ArudhranPK/VECTRON_V1/Hardware/Drawings/IMG_3359.JPG

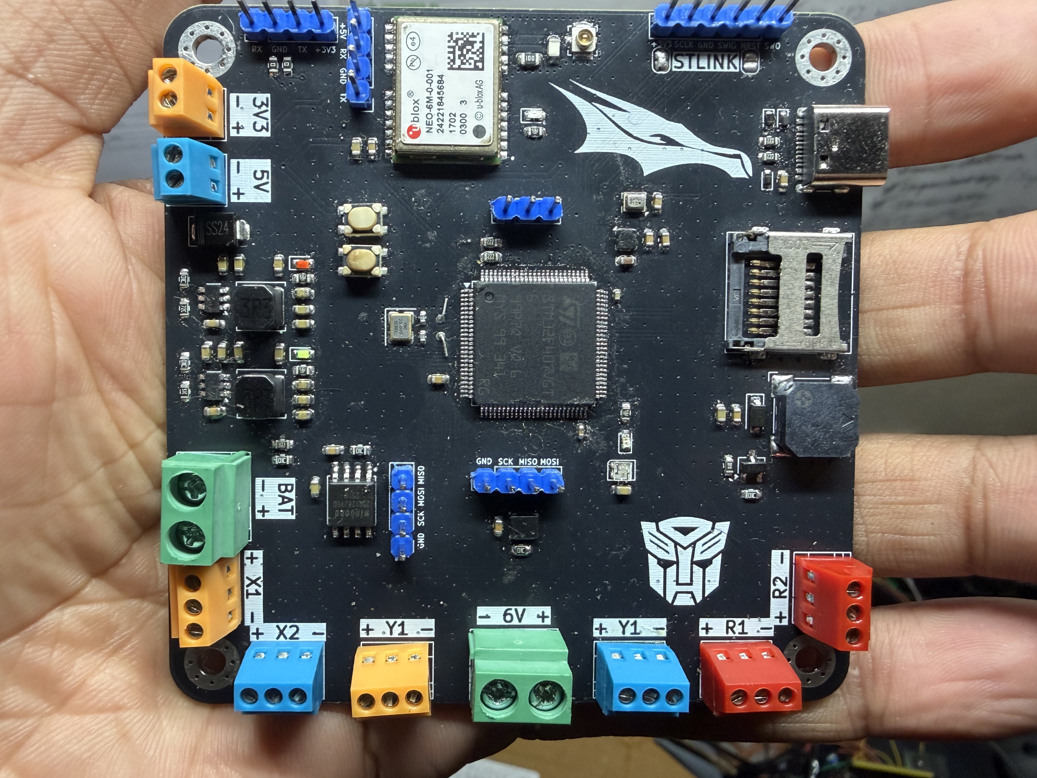
Hardware/Drawings/IMG_3359.JPG
