ArudhranPK/VECTRON_V1/Hardware/Drawings/IMG_3377.PNG

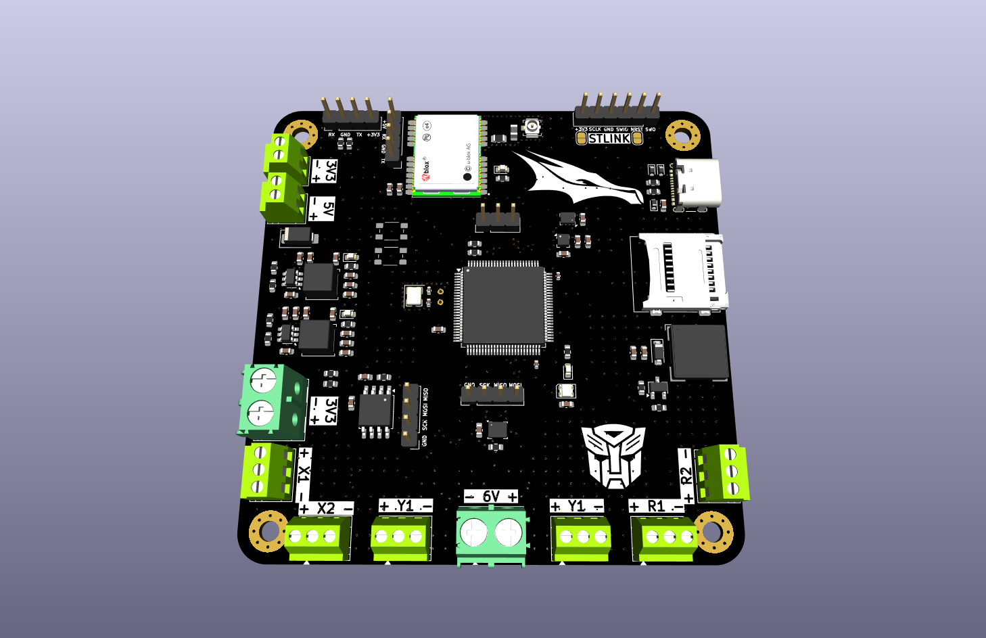
Hardware/Drawings/IMG_3377.PNG
