ArudhranPK/VECTRON_V1/Planning.md

# **Planning**

## **First thing to do**

Remember to make custom symbols
- [ ] Proper schematics with datasheet references (footprint later on)

## **Software**

### Micro SD card (SDIO)
- [x] integration testing
- [ ] Driver code

### SPI Flash (SPI)
- [x] integration testing
- [ ] Driver code

### ISM330DHCX IMU (SPI)(DMA)
- [x] Integration testing
- [x] Driver code

### LIS2MDL magnetometer (I2C)
- [x] integration testing
- [x] Driver code

### NEO-6M GPS (UART)
- [x] integration testing
- [x] Driver code

### BMP280 barometer (I2C)
- [x] integration testing
- [x] Driver code

## **Hardware**

Remeber to make custom footprints

- [x] Complete schematic fully
- [x] Check schematics (Find errors)
- [x] Check if Micro SD can be run by only 1 bit bus
- [ ] Check for simulations
- [ ] Learn about Control Systems
- [ ] Learn about Control Systems for rockets
- [ ] Check for the Op-Amp and mosfet trigger and continuity
- [ ] Check for the automatic switch from battery to usb
- [ ] Check for the reverse polarity circuit is working or not
