ArudhranPK/VECTRON_V1/Hardware/BOM.xlsx

Value | Qty |  | Exclude from BOM | Exclude from Board | Footprint
Battery_Cell | 1 | https://robu.in/product/panasonic-cr2032-3v-lithium-coin-battery-2pcs/ |  |  | Battery:BatteryHolder_Multicomp_BC-2001_1x2032_1
CL8530A-CLDZ | 1 |  |  |  | Buzzer_Beeper:MagneticBuzzer_CUI_CMT-8504-100-SMT
10uf | 29 | https://robu.in/product/0603x106m250nt-fh-25v-10uf-x5r%c2%b120-0603-multilayer-ceramic-capacitors-mlcc-smd-smt-rohs/ |  |  | Capacitor_SMD:C_0603_1608Metric
100nf | 21 | https://robu.in/product/cl10b104kb8nfnc-samsang-50v-100nf-x7r-%c2%b110-0603-multilayer-ceramic-capacitors-mlcc-smd-smt-rohs/ |  |  | Capacitor_SMD:C_0603_1608Metric
220nf | 1 | https://robu.in/product/cl10b224kb8nnnc-samsang-50v-220nf-x7r-%c2%b110-0603-multilayer-ceramic-capacitors-mlcc-smd-smt-rohs/ |  |  | Capacitor_SMD:C_0603_1608Metric
27pf | 1 | https://robu.in/product/grm1555c1h270ga01d-murata-cap-ceramic-27pf-50v-c0g-2-pad-smd-0402-125c-t-r/ |  |  | Capacitor_SMD:C_0402_1005Metric
15pf | 1 | https://robu.in/product/grm1555c1h150ga01d-murata-cap-ceramic-15pf-50v-c0g-2-pad-smd-0402-125c-t-r/ |  |  | Capacitor_SMD:C_0402_1005Metric
33pf | 1 | https://robu.in/product/grm1555c1h330ga01d-murata-cap-ceramic-33pf-50v-c0g-2-pad-smd-0402-125c-t-r/ |  |  | Capacitor_SMD:C_0402_1005Metric
22pf | 1 | https://robu.in/product/grm1555c1h220ga01d-murata-cap-ceramic-22pf-50v-c0g-2-pad-smd-0402-125c-t-r/ |  |  | Capacitor_SMD:C_0402_1005Metric
18pf | 1 | https://robu.in/product/grm1555c1h180fa01d-murata-cap-ceramic-18pf-50v-c0g-1-pad-smd-0402-125c-t-r/ |  |  | Capacitor_SMD:C_0402_1005Metric
11pf | 1 | https://robu.in/product/grm1555c1h110ga01d-murata-cap-ceramic-11pf-50v-c0g-2-pad-smd-0402-125c-t-r/ |  |  | Capacitor_SMD:C_0402_1005Metric
2u2f | 2 | https://robu.in/product/0402x225k160nt-fh-16v-2-2uf-x5r%c2%b110-0402-multilayer-ceramic-capacitors-mlcc-smd-smt-rohs/ |  |  | Capacitor_SMD:C_0402_1005Metric
SS24B-Slkor | 1 | https://robu.in/product/ss24b-slkor-40v-500mv2a-2a-smbdo-214aa-schottky-diodes-rohs/ |  |  | Diode_SMD:D_SMA
MM5Z10B | 1 | https://robu.in/product/mm5z10b-semtech-200mw-10v-sod-523-zener-diodes-rohs/ |  |  | Diode_SMD:D_SOD-523
white | 4 | https://robu.in/product/xl-1608wwc-06-xinglight-20ma-780mcd-yellow-lens-20%e2%84%8385%e2%84%83-positive-stick-white-130-70mw-3-3v-0603-led-indication-discrete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 |  |  | LED_SMD:LED_0603_1608Metric
red | 4 | https://robu.in/product/xl-1608surc-04-xinglight-20ma-360mcd-colorless-transparent-lens-615nm625nm-20%e2%84%8385%e2%84%83-positive-stick-red-120-50mw-2-4v-060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
blue | 4 | https://robu.in/product/xl-1608bgwc-06-xinglight-20ma-960mcd-green-lens-20%e2%84%8385%e2%84%83-positive-stick-blue-120-70mw-3-3v-0603-led-indication-discrete-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
green | 4 | https://robu.in/product/xl-1608sygc-06-xinglight-25ma-2800k3160k-60mcd-colorless-transparent-lens-30%e2%84%8385%e2%84%83-positive-stick-570nm575nm-yellow-gree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
1N4148W | 1 | https://robu.in/product/1n4148w-7-f-diodes-incorporated-100v-independent-type-1-25v150ma-4ns-300ma-sod-123-switching-diodes-rohs/ |  |  | Diode_SMD:D_SOD-123
WS2812B-2020 | 1 | https://robu.in/product/1-month-warranty-953/ |  |  | LED_SMD:LED_WS2812B-2020_PLCC4_2.0x2.0mm
PESD5V0U1BB | 2 | https://robu.in/product/pesd5v0u1bb115-nexperia-5-5v-bidirectional-5v-sod-523-esd-and-surge-protection-tvs-esd-rohs/ |  |  | Diode_SMD:D_SOD-523
SLESD5Z5C | 2 | https://robu.in/product/slesd5z5c-slkor-5-6v-bidirectional-5v-sod-523-esd-and-surge-protection-tvs-esd-rohs/ |  |  | Diode_SMD:D_SOD-523
BLM18AG121SN1D | 1 | https://robu.in/product/blm18ag121sn1d-murata-ferrite-beads-multi-layer-120ohm-25-100mhz-0-8a-0-18ohm-dcr-0603-t-r/ |  |  | Inductor_SMD:L_0603_1608Metric
Screw_01x02 | 1 | https://robu.in/product/xy308-2-54-xinya-2-pin-screw-terminal-blockorange/ |  |  | TerminalBlock:TerminalBlock_Xinya_XY308-2.54-2P_1x02_P2.54mm_Horizontal
Screw_01x02 | 1 | https://robu.in/product/xy308-2-54-xinya-2-pin-screw-terminal-blockblue/
Screw_01x02 | 2 |  |  |  | TerminalBlock_RND:TerminalBlock_RND_205-00045_1x02_P5.00mm_Horizontal
01x06_Pin | 1 |  |  |  | Connector_PinHeader_2.54mm:PinHeader_1x06_P2.54mm_Vertical
01x04_Pin | 4 |  |  |  | Connector_PinHeader_2.54mm:PinHeader_1x04_P2.54mm_Vertical
Micro_SD_Card | 1 |  |  |  | Connector_Card:microSD_HC_Molex_47219-2001
Screw_01x03 | 2 | https://robu.in/product/xy308-2-54-xinya-3-pin-screw-terminal-blockorange/ |  |  | TerminalBlock:TerminalBlock_Xinya_XY308-2.54-3P_1x03_P2.54mm_Horizontal
Screw_01x03 | 2 | https://robu.in/product/xy308-2-54-xinya-3-pin-screw-terminal-blockred/
Screw_01x03 | 2 | https://robu.in/product/xy308-2-54-xinya-3-pin-screw-terminal-blockblue/
01x03_Pin | 1 |  |  |  | Connector_PinHeader_2.54mm:PinHeader_1x03_P2.54mm_Vertical
USB_C_Receptacle_USB2.0_16P | 1 | https://robu.in/product/type-c-31-m-38-hroparts-5a-1-16p-female-30%e2%84%8380%e2%84%83-type-c-smd-usb-connectors-rohs/ |  |  | Connector_USB:USB_C_Receptacle_GCT_USB4105-xx-A_16P_TopMnt_Horizontal
SWPA5040S3R3NT 3u3h | 2 | https://robu.in/product/swpa5040s3r3nt-sunlord-3-3uh-30-3-4a-24-ohm-smd-5-0x5-0x4-0mm-power-inductord319/ |  |  | Inductor_SMD:L_Sunlord_SWPA5040S
27uh | 1 | https://robu.in/product/mlf2012c220kt000-tdk-5ma-22uh-%c2%b110-450m%cf%89-0805-inductors-smd-rohs/ |  |  | Inductor_SMD:L_0805_2012Metric
SiS447DN | 1 | https://robu.in/product/sis447dn-t1-ge3-vishay-sis447dn-t1-ge3-power-mosfet-p-channel-20-v-18-a-0-0058-ohm-powerpak-1212-surface-mount/ |  |  | Package_SO:Vishay_PowerPAK_1212-8_Single
AC0603FR-0710KL | 1 | https://robu.in/product/irlml2502trpbf-jsmsemi-20v-4-5a-80m%cf%891-8v2a-1-5w-1v-1-n-channel-sot-23-mosfets-rohs/ |  |  | Package_TO_SOT_SMD:TSOT-23
10k | 21 | https://robu.in/product/rc0603fr-0710kl-yageo-res-thick-film-0603-10k-ohm-1-0-1w1-10w-%c2%b1100ppm-c-pad-smd-t-r/ |  |  | Resistor_SMD:R_0603_1608Metric
2k2 | 2 | https://robu.in/product/0603waf2201t5e-uniohm-royal-ohm-100mw-thick-film-resistors-75v-%c2%b1100ppm-%e2%84%83-%c2%b11-2-2k%cf%89-0603-chip-resistor-surface-mo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 |  |  | Resistor_SMD:R_0603_1608Metric
0Î© | 3 | https://robu.in/product/0603waf0000t5e-uniohm-royal-ohm-100mw-thick-film-resistors-75v-%c2%b11-0%cf%89-0603-chip-resistor-surface-mount-rohs/ |  |  | Resistor_SMD:R_0603_1608Metric
1k | 1 | https://robu.in/product/rc0603jr-071kl-yageo-res-thick-film-0603-1k-ohm-5-0-1w1-10w-%c2%b1100ppm-c-pad-smd-t-r/ |  |  | Resistor_SMD:R_0603_1608Metric
5k1 | 4 | https://robu.in/product/0603waj0512t5e-uniohm-royal-ohm-100mw-thick-film-resistors-75v-%c2%b1100ppm-%e2%84%83-%c2%b15-5-1k%cf%89-0603-chip-resistor-surface-mo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 |  |  | Resistor_SMD:R_0603_1608Metric
33K2 | 1 | https://robu.in/product/0603waf3322t5e-uniohm-royal-ohm-100mw-thick-film-resistors-75v%c2%b1100ppm-%e2%84%83-%c2%b11-33-2k%cf%89-0603-chip-resistor-surface-mo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 |  |  | Resistor_SMD:R_0603_1608Metric
10Î© | 1 | https://robu.in/product/0805w8j0100t5e-uniohm-royal-ohm-125mw-thick-film-resistors-150v-%c2%b15-%c2%b1200ppm-%e2%84%83-10%cf%89-0805-chip-resistor-surface-mou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 |  |  | Resistor_SMD:R_0805_2012Metric
54k9 | 1 | https://robu.in/product/0603waf5492t5e-uniohm-royal-ohm-100mw-thick-film-resistors-75v-%c2%b1100ppm-%e2%84%83%c2%b11-54-9k%cf%89-0603-chip-resistor-surface-mo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 |  |  | Resistor_SMD:R_0603_1608Metric
10Î© | 1 | https://robu.in/product/0603waf100jt5e-uniohm-royal-ohm-100mw-thick-film-resistors-75v-%c2%b11-%c2%b1400ppm-%e2%84%8310%cf%89-0603-chip-resistor-surface-mount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 |  |  | Resistor_SMD:R_0603_1608Metric
360 | 1 | https://robu.in/product/0603waf3600t5e-uniohm-royal-ohm-100mw-thick-film-resistors-75v-%c2%b1100ppm-%e2%84%83-%c2%b11-360%cf%89-0603-chip-resistor-surface-mou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 |  |  | Resistor_SMD:R_0603_1608Metric
4k7 | 1 | https://robu.in/product/0603waj0472t5e-uniohm-royal-ohm-100mw-thick-film-resistors-75v-%c2%b1100ppm-%e2%84%83%c2%b15-4-7k%cf%89-0603-chip-resistor-surface-mou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 |  |  | Resistor_SMD:R_0603_1608Metric
30k | 1 | https://robu.in/product/0603waf3002t5e-uniohm-royal-ohm-100mw-thick-film-resistors-75v-%c2%b1100ppm-%e2%84%83%c2%b11-30k%cf%89-0603-chip-resistor-surface-moun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 |  |  | Resistor_SMD:R_0603_1608Metric
750 | 1 | https://robu.in/product/0603waf7500t5e-uniohm-royal-ohm-100mw-thick-film-resistors-75v-%c2%b1100ppm-%e2%84%83-%c2%b11-750%cf%89-0603-chip-resistor-surface-mou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 |  |  | Resistor_SMD:R_0603_1608Metric
27Î© | 1 | https://robu.in/product/0603waf270jt5e-uniohm-royal-ohm-100mw-thick-film-resistors-75v-%c2%b11-%c2%b1200ppm-%e2%84%83-27%cf%89-0603-chip-resistor-surface-moun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 |  |  | Resistor_SMD:R_0603_1608Metric
560 | 1 | https://robu.in/product/0603waf5600t5e-uniohm-royal-ohm-100mw-thick-film-resistors-75v-%c2%b1100ppm-%e2%84%83-%c2%b11-560%cf%89-0603-chip-resistor-surface-mou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 |  |  | Resistor_SMD:R_0603_1608Metric
22Î© | 1 | https://robu.in/product/0603waf220jt5e-uniohm-royal-ohm-100mw-thick-film-resistors-75v-%c2%b1100ppm-%e2%84%83%c2%b11-22%cf%89-0603-chip-resistor-surface-mount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 |  |  | Resistor_SMD:R_0603_1608Metric
TSA017A2518B | 2 | https://robu.in/product/tsa017a2518b-bzcn-3-4mm-2-5mm-50ma-5-2mm-30000-times-180gf-12v-smd-4p5-2x3-3mm-tactile-switches-rohs/ |  |  | TSA017A2518B:TSA017A2518B
BMP280 | 1 |  |  |  | Package_LGA:Bosch_LGA-8_2x2.5mm_P0.65mm_ClockwisePinNumbering
LIS2MDL | 1 |  |  |  | Package_LGA:LGA-12_2x2mm_P0.5mm
ISM330DHCX | 1 |  |  |  | Package_LGA:LGA-14_3x2.5mm_P0.5mm_LayoutBorder3x4y
NEO-6M-GPS | 1 |  |  |  | NEO-6M-GPS:XCVR_NEO-6M-GPS
TPS563201 | 2 | https://robu.in/product/tps563201ddcr-texas-instruments-step-down-type-adjustable-768mv7v-3a-4-5v17v-sot-23-thin-6-dc-dc-converters-rohs/ |  |  | Package_TO_SOT_SMD:SOT-23-6
W25Q128JVS | 1 |  |  |  | Package_SO:SOIC-8_5.3x5.3mm_P1.27mm
STM32F407VGTx | 1 |  |  |  | Package_QFP:LQFP-100_14x14mm_P0.5mm
YSX321SL-25MHz | 1 |  |  |  | Crystal:Crystal_SMD_3225-4Pin_3.2x2.5mm
YXC-Y-26 | 1 |  |  |  | Crystal:Crystal_DS26_D2.0mm_L6.0mm_Horizontal
