ArudhranPK/VECTRON_V1/Hardware/robuBOM.xlsx

MPN | Qty
0603X106M250NT | 87
CL10B104KA8NNWC | 63
CL10B224KB8NNNC | 3
GRM1555C1H270GA01D | 3
GRM1555C1H150GA01D | 3
GRM1555C1H330GA01D | 3
GRM1555C1H220GA01D | 3
GRM1555C1H180FA01D | 3
GRM1555C1H110GA01D | 3
0402X225K160NT | 6
SS24B | 3
MM5Z10B | 3
XL-1608WWC-06 | 12
XL-1608SURC-04 | 12
XL-1608BGWC-06 | 12
XL-1608SYGC-06 | 12
1N4148W-7-F | 3
XL-2020RGBC-WS2812B | 3
SLESD5Z5C | 6
BLM18AG121SN1D | 3
SWPA5040S3R3NT | 6
MLF2012C220KT000 | 3
SIS447DN-T1-GE3 | 3
AO3400A | 3
AC0603FR-0710KL | 63
0603WAF2201T5E | 6
0603WAF0000T5E | 9
RC0603JR-071KL | 3
0603WAJ0512T5E | 12
0603WAF3322T5E | 3
0805W8J0100T5E | 3
0603WAF5492T5E | 3
0603WAF100JT5E | 3
0603WAF3600T5E | 3
0603WAJ0472T5E | 3
0603WAF3002T5E | 3
0603WAF7500T5E | 3
0603WAF270JT5E | 3
0603WAF5600T5E | 3
0603WAF220JT5E | 3
TSA017A2518B | 6
TPS563201DDCR | 6
