ArudhranPK/VECTRON_V1/Hardware/Drawings/PCB.pdf

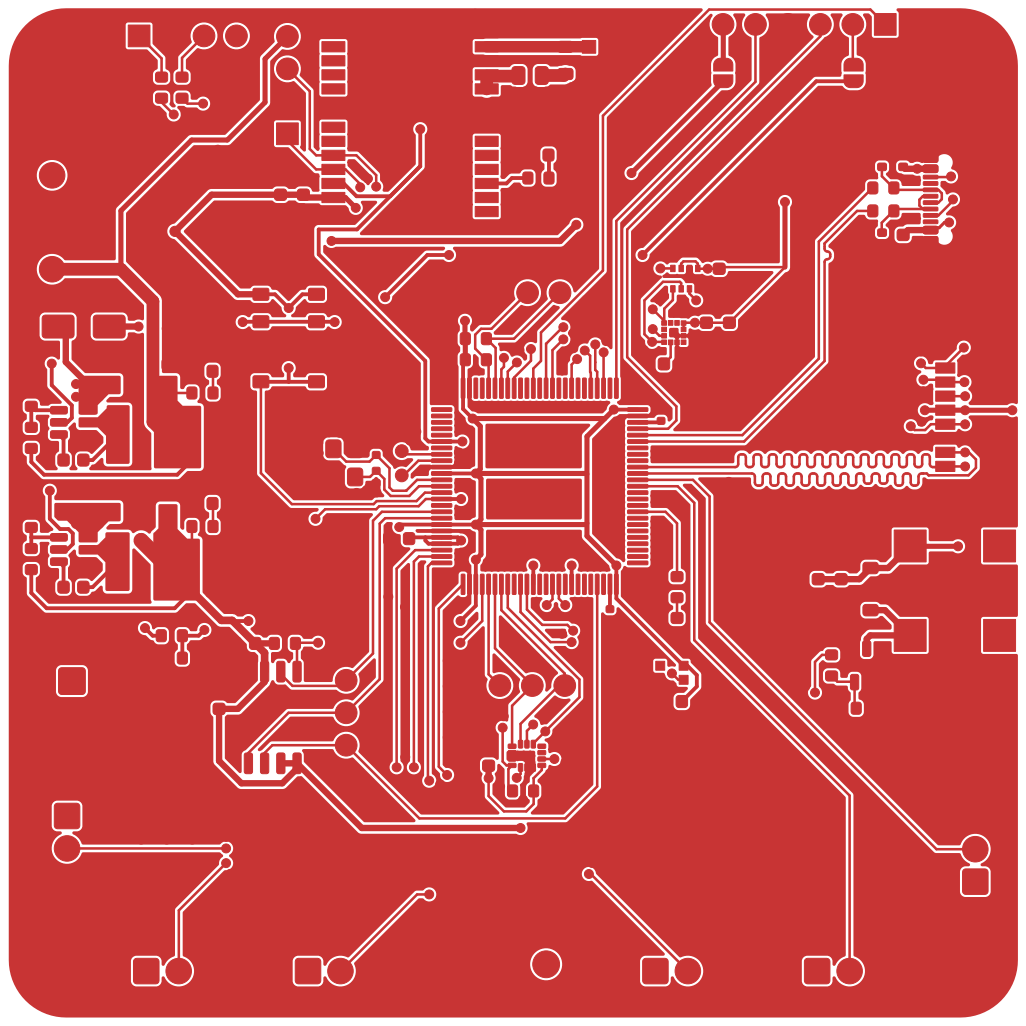
[picture p3: page 1]

Id: 1/2 Title: File: VECTRON_V1.kicad_pcb Sheet:

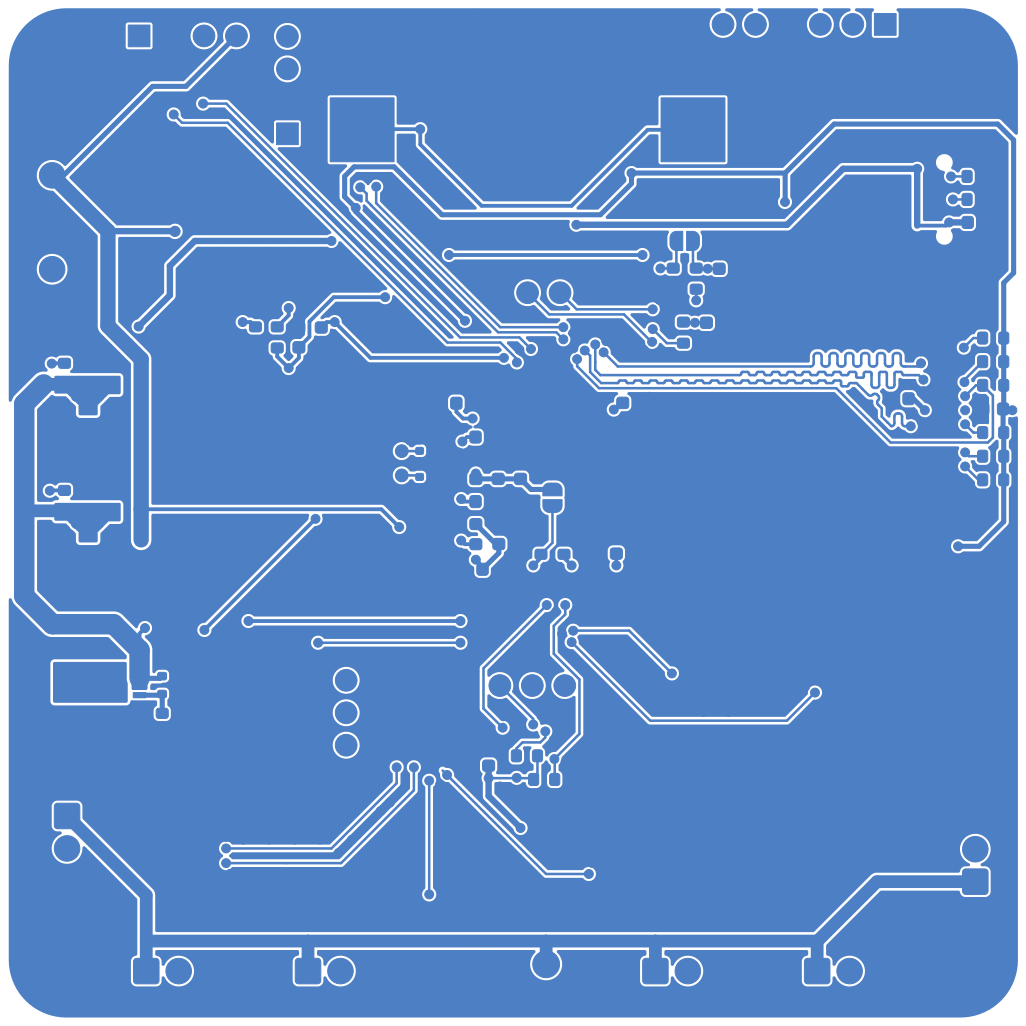
[picture p4: page 2]

Id: 2/2 Title: File: VECTRON_V1.kicad_pcb Sheet:
