ArudhranPK/VECTRON_V1/Hardware/Drawings/Schematics.pdf

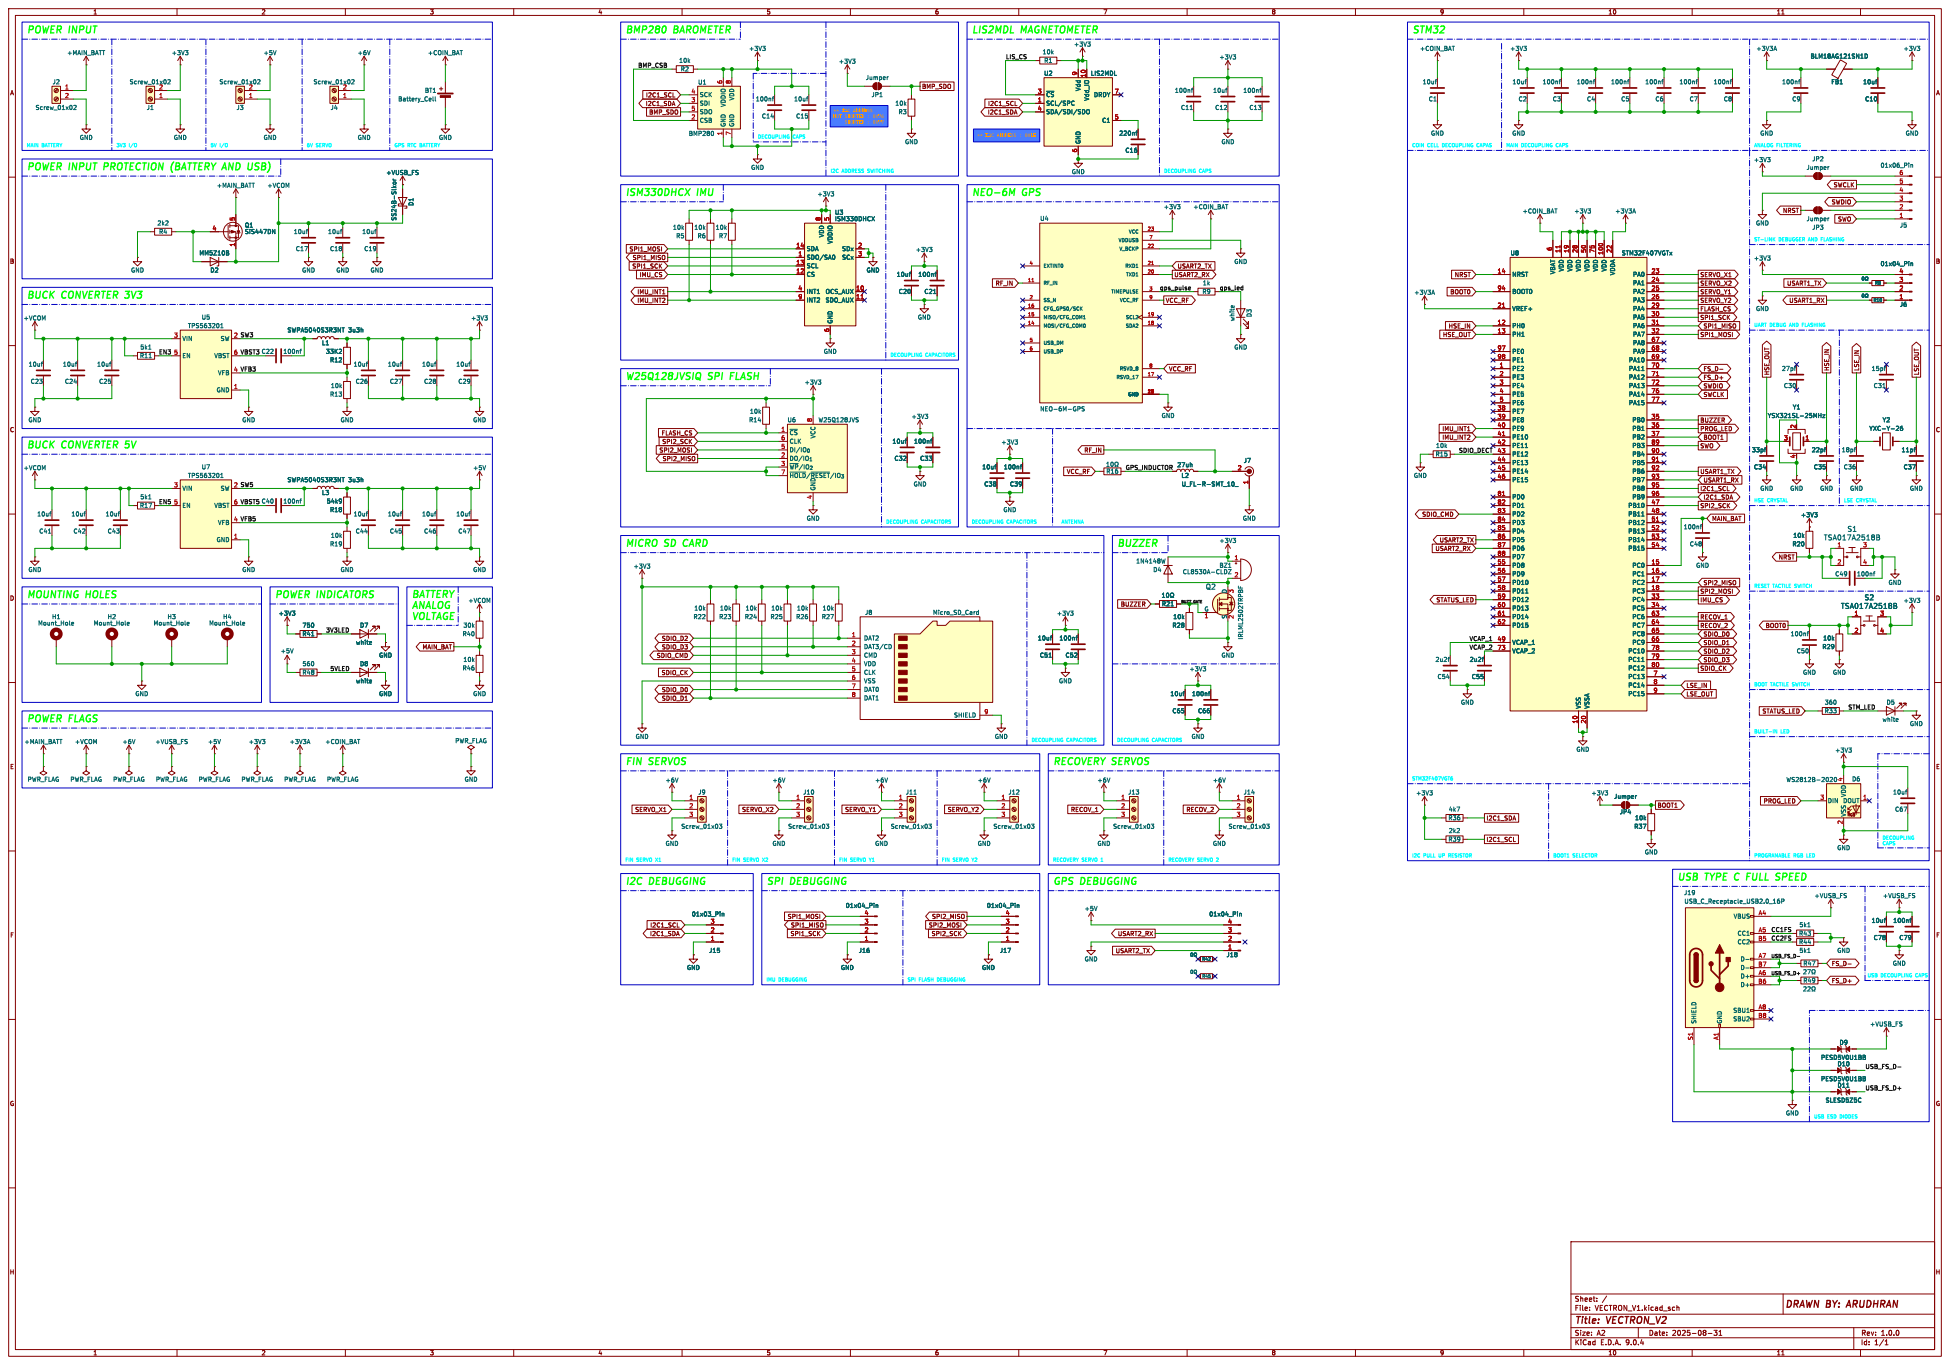
[picture p5: page 1]

MAIN BATTERY POWER INPUT

** I2C ADDRESS NOT SHORTED: 0X76 SHORTED: 0X77

COIN CELL DECOUPLING CAPAS DECOUPLING CAPS
ISM330DHCX GND

MAIN DECOUPLING CAPS POWER FLAGS
POWER INPUT PROTECTION (BATTERY AND USB)
DECOUPLING CAPS MOUNTING HOLES

SDA 14 SDO/SA0 1 SCL 13 CS 12

6 VDD 11 VDD 19 VDD 28 VSS 10 VDD 50 VSSA 20 VDD 75 VDD 100 VDDA 22 PA0
14 BOOT0

INT1 4
DECOUPLING CAPACITORS

RECOVERY SERVO 2 GPS DEBUGGING

USB TYPE C FULL SPEED
