ArudhranPK/VECTRON_V1/Hardware/KiCAD files/VECTRON_V1.kicad_pcb

## KiCad design Hardware/KiCAD files/VECTRON_V1.kicad_pcb (2025-11-18)

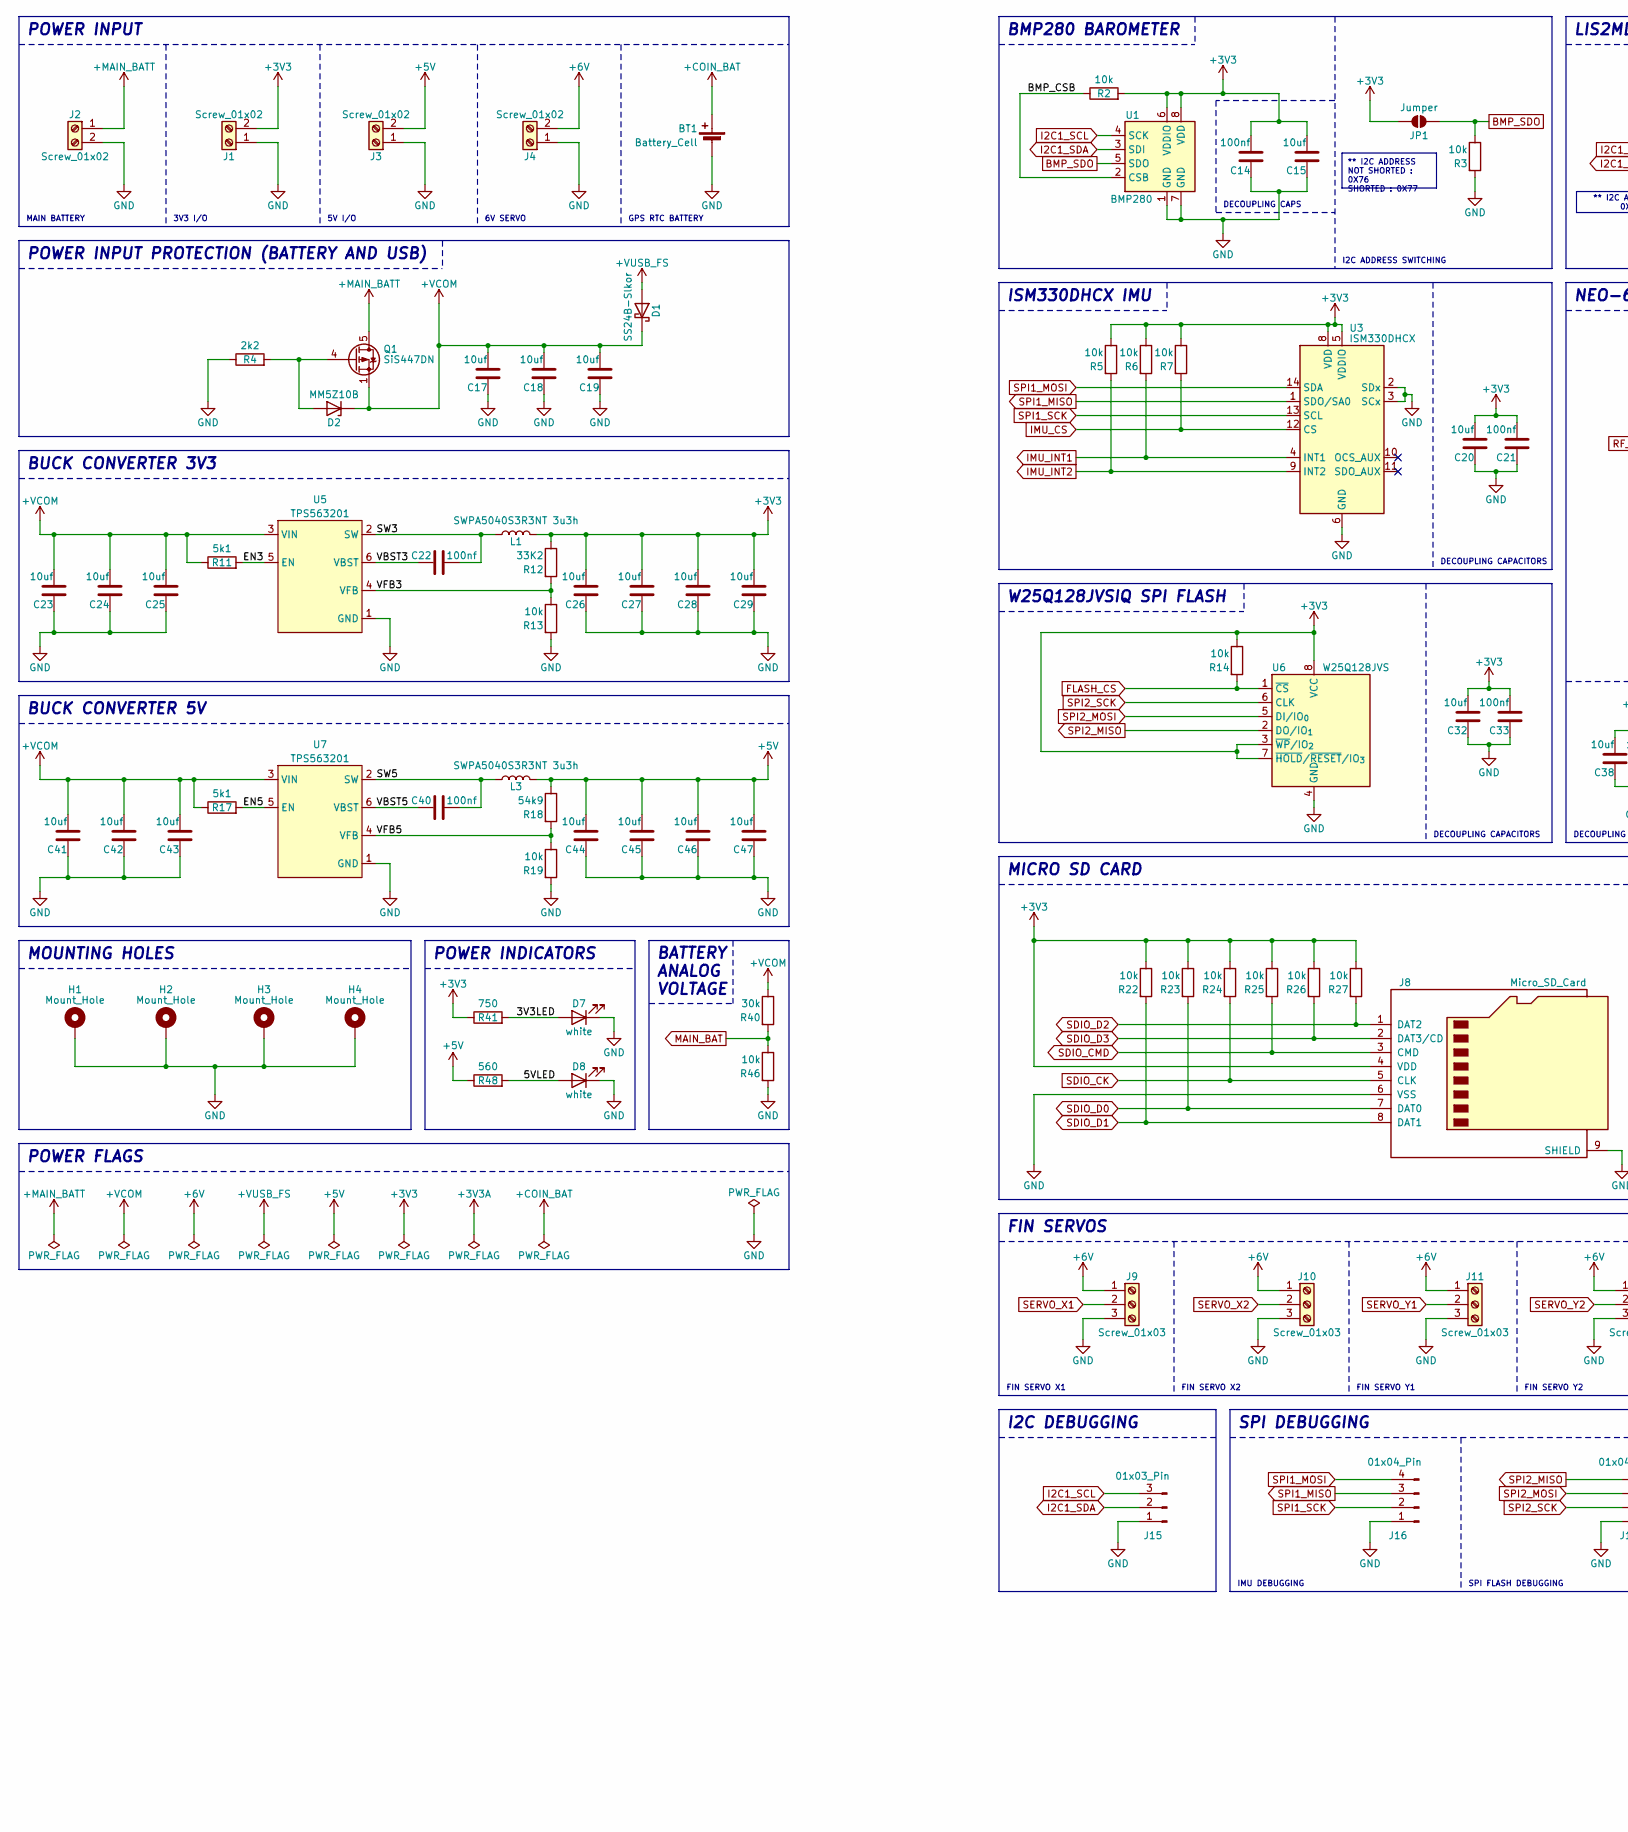
[picture p6: schematic VECTRON_V1.kicad_sch, VECTRON_V2, part in row 1, column 1]

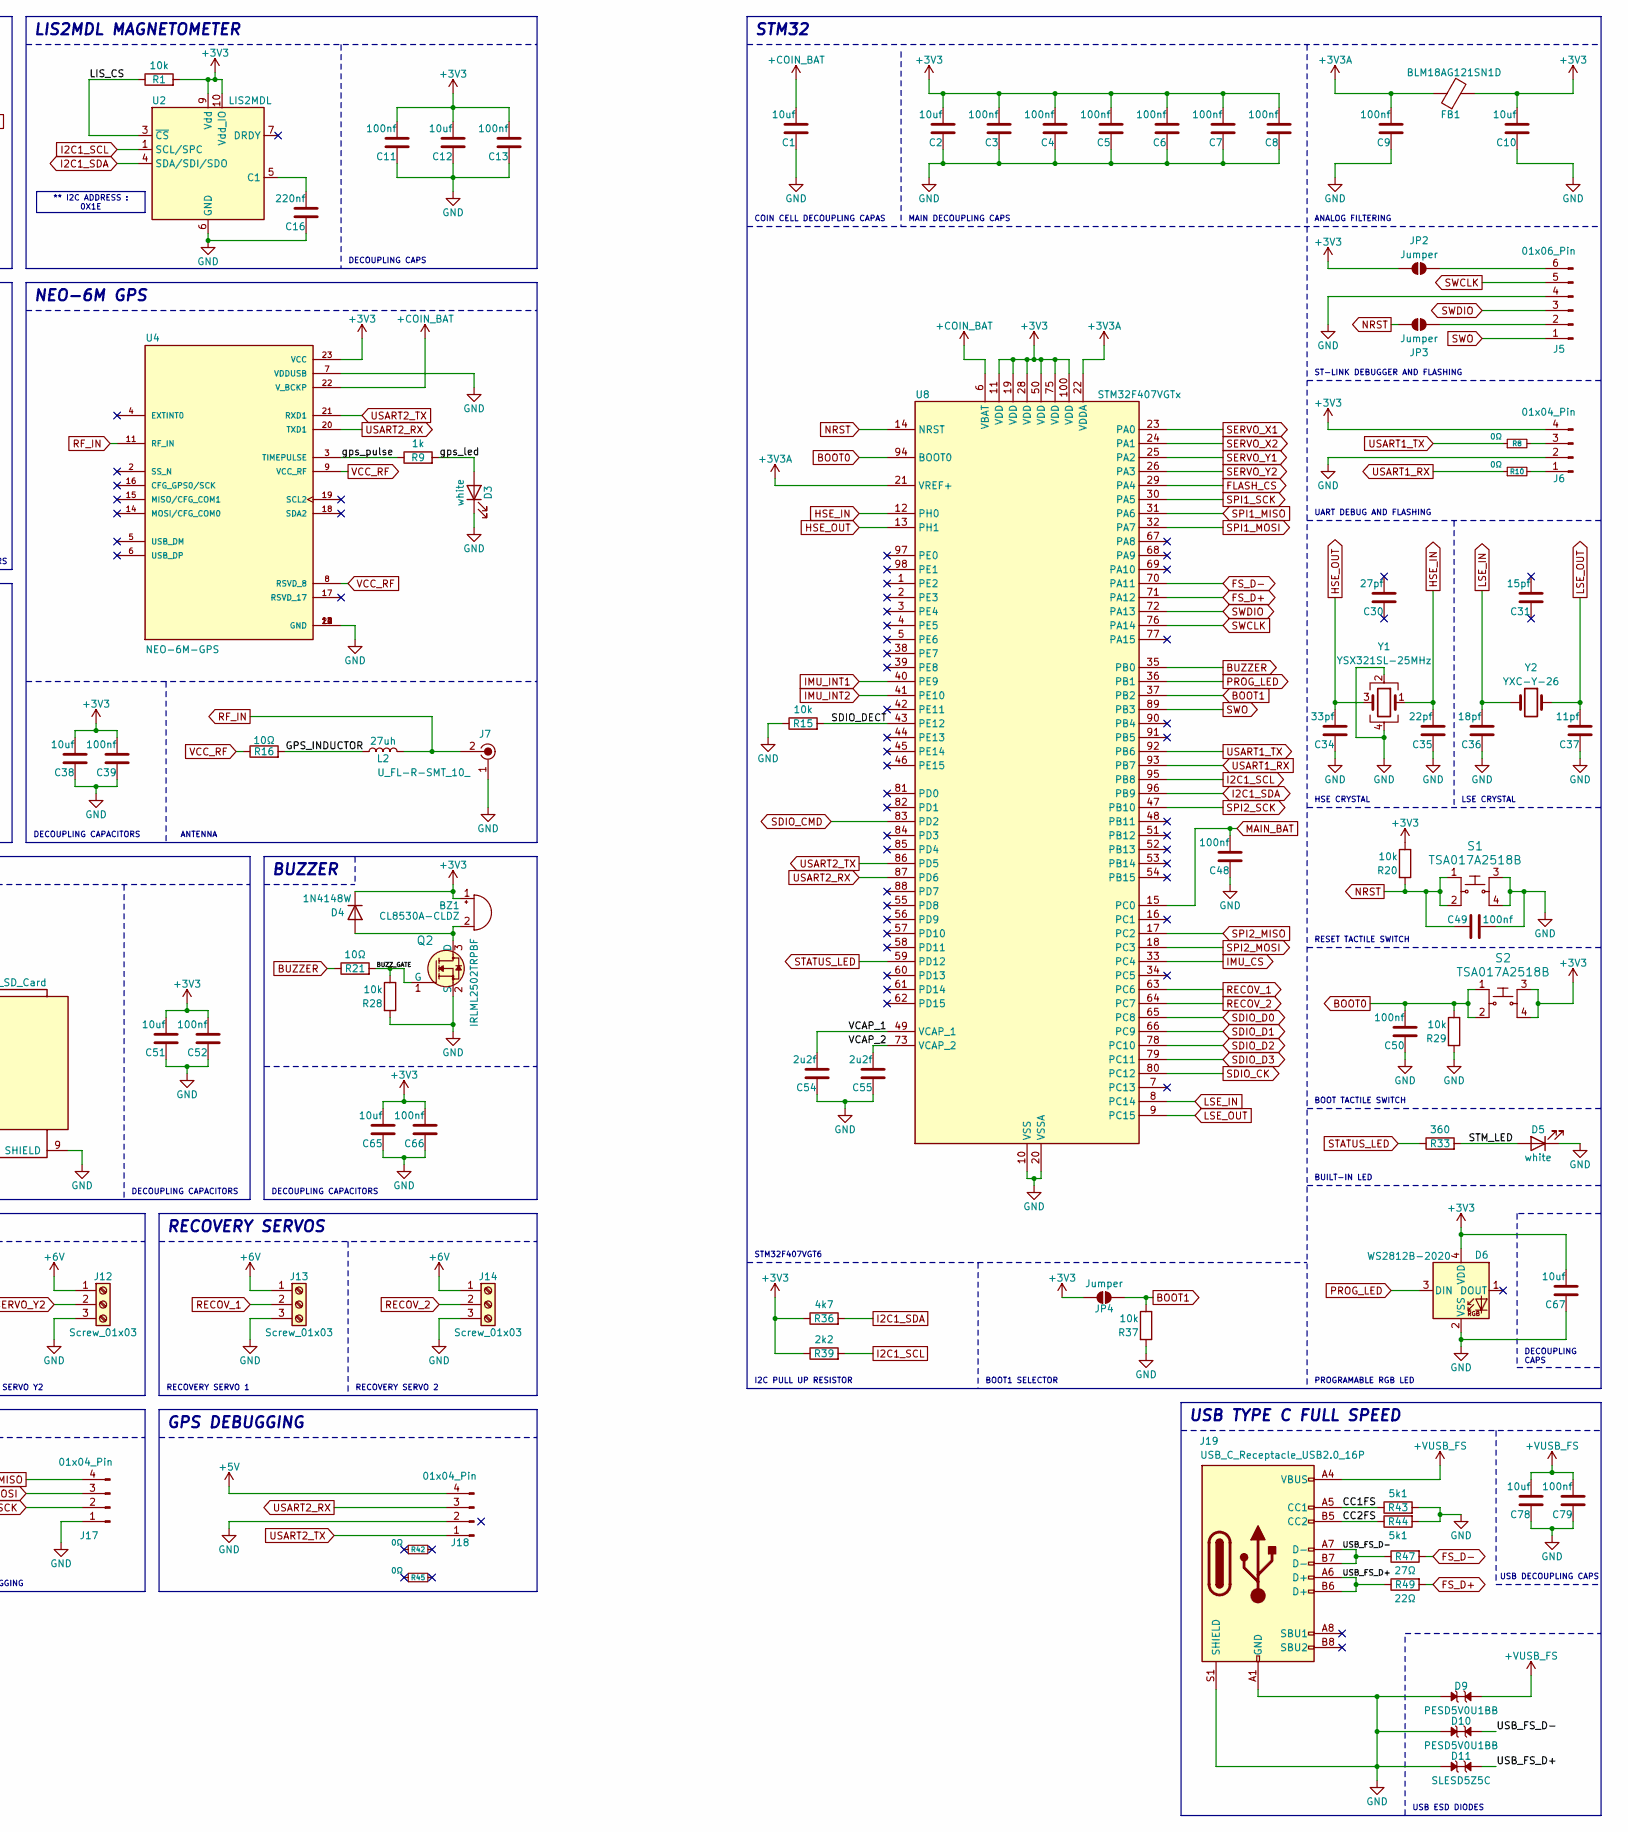
[picture p7: schematic VECTRON_V1.kicad_sch, VECTRON_V2, part in row 1, column 2]

Parts:
BT1: Battery_Cell; BatteryHolder_Multicomp_BC-2001_1x2032_1
BZ1: CL8530A-CLDZ; MagneticBuzzer_CUI_CMT-8504-100-SMT
C1, C2, C10, C12, C15, C17, C18, C19, C20, C23, C24, C25, C26, C27, C28, C29, C32, C38, C41, C42, C43, C44, C45, C46, C47, C51, C65, C67, C78: 10uf; C_0603_1608Metric
C3, C4, C5, C6, C7, C8, C9, C11, C13, C14, C21, C22, C33, C39, C40, C48, C49, C50, C52, C66, C79: 100nf; C_0603_1608Metric
C16: 220nf; C_0603_1608Metric
C30: 27pf; C_0402_1005Metric
C31: 15pf; C_0402_1005Metric
C34: 33pf; C_0402_1005Metric
C35: 22pf; C_0402_1005Metric
C36: 18pf; C_0402_1005Metric
C37: 11pf; C_0402_1005Metric
C54, C55: 2u2f; C_0402_1005Metric
D1: SS24B-Slkor; D_SMA
D2: MM5Z10B; D_SOD-523
D3, D5, D7, D8: white; LED_0603_1608Metric
D4: 1N4148W; D_SOD-123
D6: WS2812B-2020; LED_WS2812B-2020_PLCC4_2.0x2.0mm
D9, D10: PESD5V0U1BB; D_SOD-523
D11: SLESD5Z5C; D_SOD-523
FB1: BLM18AG121SN1D; L_0603_1608Metric
H1, H2, H3, H4: Mount_Hole; MountingHole_3.2mm_M3_Pad_Via
J1, J3: Screw_01x02; TerminalBlock_Xinya_XY308-2.54-2P_1x02_P2.54mm_Horizontal
J2, J4: Screw_01x02; TerminalBlock_RND_205-00045_1x02_P5.00mm_Horizontal
J5: 01x06_Pin; PinHeader_1x06_P2.54mm_Vertical
J6, J16, J17, J18: 01x04_Pin; PinHeader_1x04_P2.54mm_Vertical
J7: U_FL-R-SMT_10_; Coax_Conn_U.FL; MPN U.FL-R-SMT(10); Digi-Key_PN H9161CT-ND
J8: Micro_SD_Card; microSD_HC_Molex_47219-2001
J9, J10, J11, J12, J13, J14: Screw_01x03; TerminalBlock_Xinya_XY308-2.54-3P_1x03_P2.54mm_Horizontal
J15: 01x03_Pin; PinHeader_1x03_P2.54mm_Vertical
J19: USB_C_Receptacle_USB2.0_16P; USB_C_Receptacle_GCT_USB4105-xx-A_16P_TopMnt_Horizontal
JP1, JP2, JP3, JP4: Jumper; SolderJumper-2_P1.3mm_Open_RoundedPad1.0x1.5mm
L1, L3: SWPA5040S3R3NT 3u3h; L_Sunlord_SWPA5040S
L2: 27uh; L_0805_2012Metric
Q1: SiS447DN; Vishay_PowerPAK_1212-8_Single
Q2: IRLML2502TRPBF; TSOT-23; MPN IRLML2502TRPBF; Digi-Key_PN IRLML2502TRPBFCT-ND
R1, R2, R3, R5, R6, R7, R13, R14, R15, R19, R20, R22, R23, R24, R25, R26, R27, R28, R29, R37, R46: 10k; R_0603_1608Metric
R4, R39: 2k2; R_0603_1608Metric
R8, R10, R42, R45: 0Ω; R_0603_1608Metric
R9: 1k; R_0603_1608Metric
R11, R17, R43, R44: 5k1; R_0603_1608Metric
R12: 33K2; R_0603_1608Metric
R16: 10Ω; R_0805_2012Metric
R18: 54k9; R_0603_1608Metric
R21: 10Ω; R_0603_1608Metric
R33: 360; R_0603_1608Metric
R36: 4k7; R_0603_1608Metric
R40: 30k; R_0603_1608Metric
R41: 750; R_0603_1608Metric
R47: 27Ω; R_0603_1608Metric
R48: 560; R_0603_1608Metric
R49: 22Ω; R_0603_1608Metric
S1, S2: TSA017A2518B; MPN B3F-1000; Digi-Key_PN SW400-ND
U1: BMP280; Bosch_LGA-8_2x2.5mm_P0.65mm_ClockwisePinNumbering
U2: LIS2MDL; LGA-12_2x2mm_P0.5mm
U3: ISM330DHCX; LGA-14_3x2.5mm_P0.5mm_LayoutBorder3x4y
U4: NEO-6M-GPS; XCVR_NEO-6M-GPS; PARTREV R15
U5, U7: TPS563201; SOT-23-6
U6: W25Q128JVS; SOIC-8_5.3x5.3mm_P1.27mm
U8: STM32F407VGTx; LQFP-100_14x14mm_P0.5mm
Y1: YSX321SL-25MHz; Crystal_SMD_3225-4Pin_3.2x2.5mm
Y2: YXC-Y-26; Crystal_DS26_D2.0mm_L6.0mm_Horizontal

Connections:
+3V3: BZ1.1 (+), C2.2, C3.2, C4.2, C5.2, C6.2, C7.2, C8.2, C10.2, C11.2, C12.2, C13.2, C14.2, C15.2, C20.2, C21.2, C26.2, C27.2, C28.2, C29.2, C32.2, C33.2, C38.2, C39.2, C51.2, C52.2, C65.2, C66.2, C67.2, D4.1 (K), D6.4 (VDD), FB1.2, J1.2, J6.4, J8.4 (VDD), JP1.2 (B), JP2.1 (A), JP4.2 (B), L1.2, R1.2, R2.2, R5.1, R6.1, R7.1, R12.1, R14.1, R20.1, R22.1, R23.1, R24.1, R25.1, R26.1, R27.1, R36.1, R39.1, R41.1, S2.3, S2.4, U1.6 (VDDIO), U1.8 (VDD), U2.9 (Vdd), U2.10 (Vdd_IO), U3.5 (VDDIO), U3.8 (VDD), U4.23 (VCC), U6.3 (~WP/IO_{2}), U6.7 (~HOLD/~RESET/IO_{3}), U6.8 (VCC), U8.11 (VDD), U8.19 (VDD), U8.28 (VDD), U8.50 (VDD), U8.75 (VDD), U8.100 (VDD)
+3V3A: C9.2, FB1.1, U8.21 (VREF+), U8.22 (VDDA)
+5V: C44.2, C45.2, C46.2, C47.2, J3.2, J18.4, L3.2, R18.1, R48.1
+6V: J4.2, J9.1, J10.1, J11.1, J12.1, J13.1, J14.1
+COIN_BAT: BT1.1 (+), C1.2, U4.22 (V_BCKP), U8.6 (VBAT)
+MAIN_BATT: J2.1, Q1.5 (D)
+VCOM: C17.2, C18.2, C19.2, C23.2, C24.2, C25.2, C41.2, C42.2, C43.2, D1.1 (K), D2.1 (K), Q1.1 (S), Q1.2 (S), Q1.3 (S), R11.1, R17.1, R40.1, U5.3 (VIN), U7.3 (VIN)
+VUSB_FS: C78.2, C79.2, D1.2 (A), D9.2, J19.A4 (VBUS), J19.A9 (VBUS), J19.B4 (VBUS), J19.B9 (VBUS)
/3V3LED: D7.2 (A), R41.2
/5VLED: D8.2 (A), R48.2
/BMP_CSB: R2.1, U1.2 (CSB)
/BUZZ_GATE: Q2.1 (G), R21.2, R28.1
/CC1FS: J19.A5 (CC1), R43.1
/CC2FS: J19.B5 (CC2), R44.1
/EN3: R11.2, U5.5 (EN)
/EN5: R17.2, U7.5 (EN)
/GPS_INDUCTOR: L2.1, R16.2
/LIS_CS: R1.1, U2.3 (~CS)
/SDIO_DECT: R15.2, U8.43 (PE12)
/STM_LED: D5.2 (A), R33.2
/SW3: C22.2, L1.1, U5.2 (SW)
/SW5: C40.2, L3.1, U7.2 (SW)
/USB_FS_D+: D11.2, J19.A6 (D+), J19.B6 (D+), R49.1
/USB_FS_D-: D10.2, J19.A7 (D-), J19.B7 (D-), R47.1
/VBST3: C22.1, U5.6 (VBST)
/VBST5: C40.1, U7.6 (VBST)
/VCAP_1: C54.2, U8.49 (VCAP_1)
/VCAP_2: C55.2, U8.73 (VCAP_2)
/VFB3: R12.2, R13.1, U5.4 (VFB)
/VFB5: R18.2, R19.1, U7.4 (VFB)
/gps_led: D3.2 (A), R9.2
/gps_pulse: R9.1, U4.3 (TIMEPULSE)
BMP_SDO: JP1.1 (A), R3.1, U1.5 (SDO)
BOOT0: C50.2, R29.1, S2.1, S2.2, U8.94 (BOOT0)
BOOT1: JP4.1 (A), R37.1, U8.37 (PB2)
BUZZER: R21.1, U8.35 (PB0)
FLASH_CS: R14.2, U6.1 (~CS), U8.29 (PA4)
FS_D+: R49.2, U8.71 (PA12)
FS_D-: R47.2, U8.70 (PA11)
GND: BT1.2 (-), C1.1, C2.1, C3.1, C4.1, C5.1, C6.1, C7.1, C8.1, C9.1, C10.1, C11.1, C12.1, C13.1, C14.1, C15.1, C16.1, C17.1, C18.1, C19.1, C20.1, C21.1, C23.1, C24.1, C25.1, C26.1, C27.1, C28.1, C29.1, C32.1, C33.1, C34.1, C35.1, C36.1, C37.1, C38.1, C39.1, C41.1, C42.1, C43.1, C44.1, C45.1, C46.1, C47.1, C48.1, C49.2, C50.1, C51.1, C52.1, C54.1, C55.1, C65.1, C66.1, C67.1, C78.1, C79.1, D3.1 (K), D5.1 (K), D6.2 (VSS), D7.1 (K), D8.1 (K), D9.1, D10.1, D11.1, H1.1, H2.1, H3.1, H4.1, J1.1, J2.2, J3.1, J4.1, J5.4, J6.2, J7.1, J8.6 (VSS), J8.9 (SHIELD), J9.3, J10.3, J11.3, J12.3, J13.3, J14.3, J15.1, J16.1, J17.1, J18.2, J19.A1 (GND), J19.A12 (GND), J19.B1 (GND), J19.B12 (GND), J19.S1 (SHIELD), Q2.2 (S), R3.2, R4.1, R13.2, R15.1, R19.2, R28.2, R29.2, R37.2, R43.2, R44.2, R46.2, S1.3, S1.4, U1.1 (GND), U1.7 (GND), U2.6 (GND), U2.8 (GND), U3.2 (SDx), U3.3 (SCx), U3.6 (GND), U3.7 (GND), U4.7 (VDDUSB), U4.10 (GND), U4.12 (GND), U4.13 (GND), U4.24 (GND), U5.1 (GND), U6.4 (GND), U7.1 (GND), U8.10 (VSS), U8.20 (VSSA), U8.27 (VSS), U8.74 (VSS), U8.99 (VSS), Y1.2, Y1.4
HSE_IN: C35.2, U8.12 (PH0), Y1.1
HSE_OUT: C34.2, U8.13 (PH1), Y1.3
I2C1_SCL: J15.3, R39.2, U1.4 (SCK), U2.1 (SCL/SPC), U8.95 (PB8)
I2C1_SDA: J15.2, R36.2, U1.3 (SDI), U2.4 (SDA/SDI/SDO), U8.96 (PB9)
IMU_CS: R7.2, U3.12 (CS), U8.33 (PC4)
IMU_INT1: R6.2, U3.4 (INT1), U8.40 (PE9)
IMU_INT2: R5.2, U3.9 (INT2), U8.41 (PE10)
LSE_IN: C36.2, U8.8 (PC14), Y2.2
LSE_OUT: C37.2, U8.9 (PC15), Y2.1
MAIN_BAT: C48.2, R40.2, R46.1, U8.15 (PC0)
NRST: C49.1, JP3.1 (A), R20.2, S1.1, S1.2, U8.14 (NRST)
unnamed: BZ1.2 (-), D4.2 (A), Q2.3 (D)
unnamed: D2.2 (A), Q1.4 (G), R4.2
unnamed: J5.2, JP3.2 (B)
unnamed: J5.6, JP2.2 (B)
unnamed: J6.1, R10.2
unnamed: J6.3, R8.2
unnamed: C16.2, U2.5 (C1)
PROG_LED: D6.3 (DIN), U8.36 (PB1)
RECOV_1: J13.2, U8.63 (PC6)
RECOV_2: J14.2, U8.64 (PC7)
RF_IN: J7.2, L2.2, U4.11 (RF_IN)
SDIO_CK: J8.5 (CLK), R24.2, U8.80 (PC12)
SDIO_CMD: J8.3 (CMD), R25.2, U8.83 (PD2)
SDIO_D0: J8.7 (DAT0), R23.2, U8.65 (PC8)
SDIO_D1: J8.8 (DAT1), R22.2, U8.66 (PC9)
SDIO_D2: J8.1 (DAT2), R27.2, U8.78 (PC10)
SDIO_D3: J8.2 (DAT3/CD), R26.2, U8.79 (PC11)
SERVO_X1: J9.2, U8.23 (PA0)
SERVO_X2: J10.2, U8.24 (PA1)
SERVO_Y1: J11.2, U8.25 (PA2)
SERVO_Y2: J12.2, U8.26 (PA3)
SPI1_MISO: J16.3, U3.1 (SDO/SA0), U8.31 (PA6)
SPI1_MOSI: J16.4, U3.14 (SDA), U8.32 (PA7)
SPI1_SCK: J16.2, U3.13 (SCL), U8.30 (PA5)
SPI2_MISO: J17.4, U6.2 (DO/IO_{1}), U8.17 (PC2)
SPI2_MOSI: J17.3, U6.5 (DI/IO_{0}), U8.18 (PC3)
SPI2_SCK: J17.2, U6.6 (CLK), U8.47 (PB10)
STATUS_LED: R33.1, U8.59 (PD12)
SWCLK: J5.5, U8.76 (PA14)
SWDIO: J5.3, U8.72 (PA13)
SWO: J5.1, U8.89 (PB3)
USART1_RX: R10.1, U8.93 (PB7)
USART1_TX: R8.1, U8.92 (PB6)
USART2_RX: J18.3, U4.20 (TXD1), U8.87 (PD6)
USART2_TX: J18.1, U4.21 (RXD1), U8.86 (PD5)
VCC_RF: R16.1, U4.8 (RSVD_8), U4.9 (VCC_RF)

Notes on the sheet:
BUCK CONVERTER 3V3
STM32F407VGT6
DECOUPLING CAPS
LIS2MDL MAGNETOMETER
BOOT TACTILE SWITCH
UART DEBUG AND FLASHING
FIN SERVO X2
DECOUPLING CAPACITORS
NEO-6M GPS
POWER INDICATORS
BOOT1 SELECTOR
MICRO SD CARD
SPI FLASH DEBUGGING
DECOUPLING CAPS
STM32
I2C ADDRESS SWITCHING
RECOVERY SERVO 2
ST-LINK DEBUGGER AND FLASHING
USB TYPE C FULL SPEED
GPS RTC BATTERY
6V SERVO
RECOVERY SERVO 1
FIN SERVO Y2
BUCK CONVERTER 5V
POWER INPUT
FIN SERVO X1
FIN SERVO Y1
ANALOG FILTERING
LSE CRYSTAL
MOUNTING HOLES
BATTERY ANALOG VOLTAGE
W25Q128JVSIQ SPI FLASH
SPI DEBUGGING
RECOVERY SERVOS
MAIN BATTERY
USB DECOUPLING CAPS
ISM330DHCX IMU
3V3 I/O
5V I/O
COIN CELL DECOUPLING CAPAS
MAIN DECOUPLING CAPS
PROGRAMABLE RGB LED
HSE CRYSTAL
POWER INPUT PROTECTION (BATTERY AND USB)
IMU DEBUGGING
BMP280 BAROMETER
POWER FLAGS
GPS DEBUGGING
BUZZER
I2C PULL UP RESISTOR
RESET TACTILE SWITCH
I2C DEBUGGING
BUILT-IN LED
FIN SERVOS
USB ESD DIODES
ANTENNA
** I2C ADDRESS NOT SHORTED : 0X76 SHORTED : 0X77
** I2C ADDRESS : 0X1E

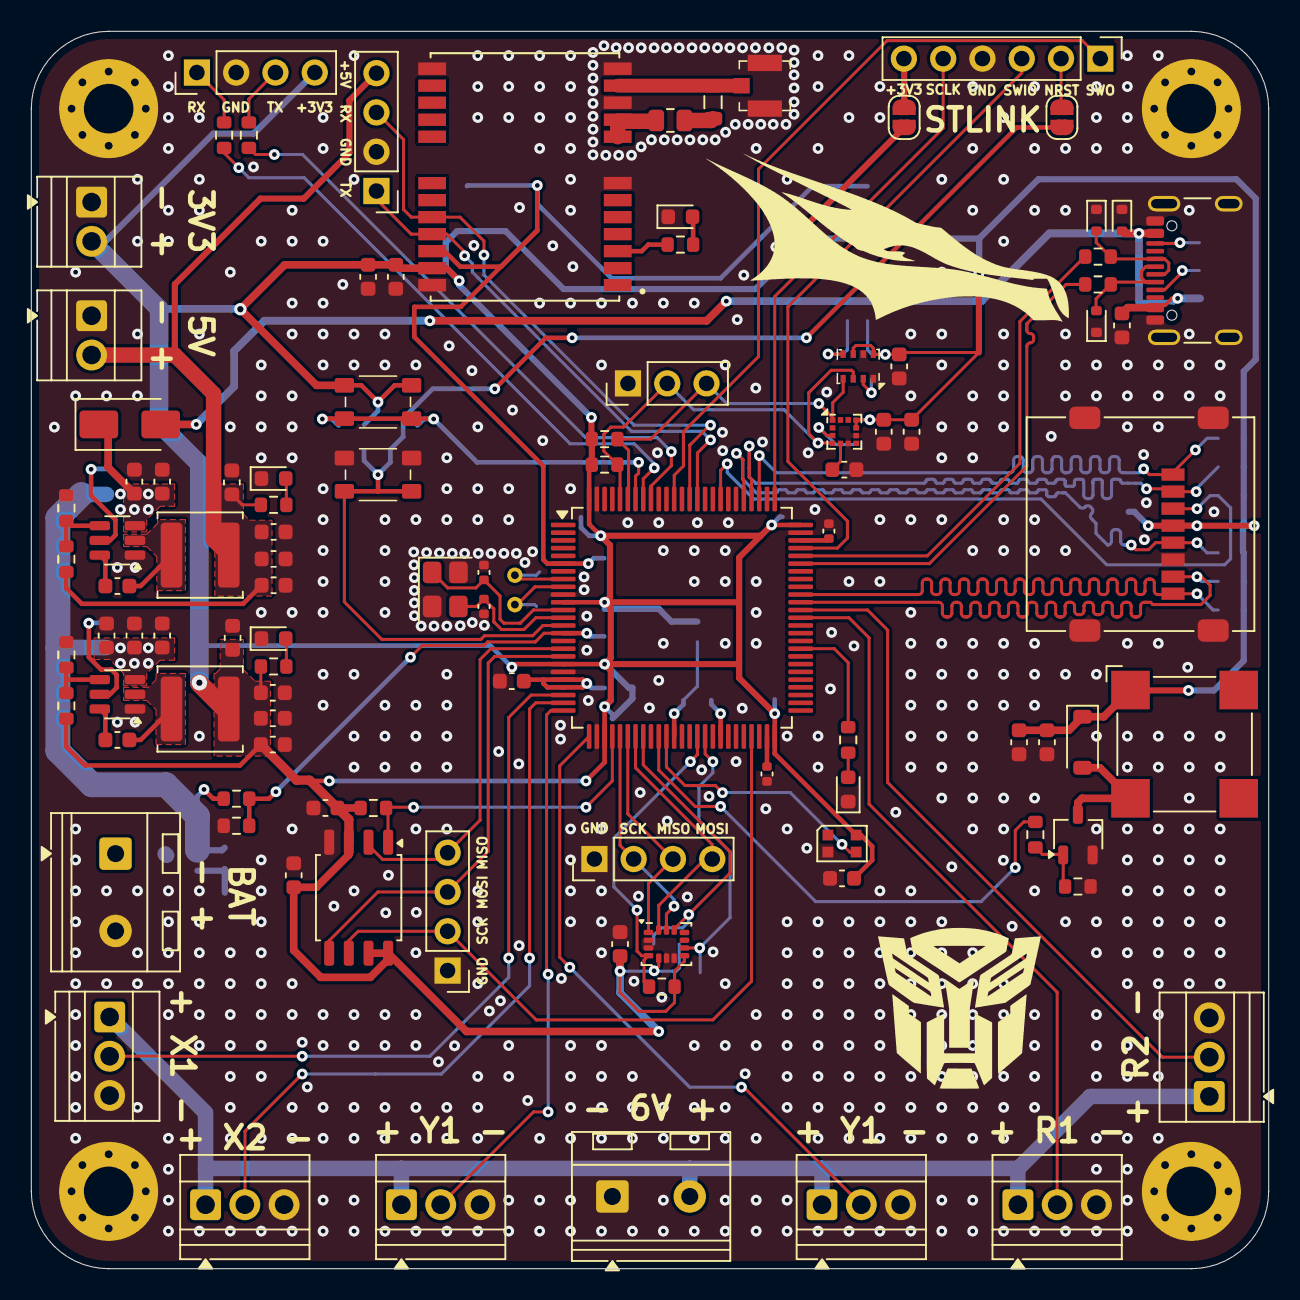
[picture p8: board VECTRON_V1.kicad_pcb from above]

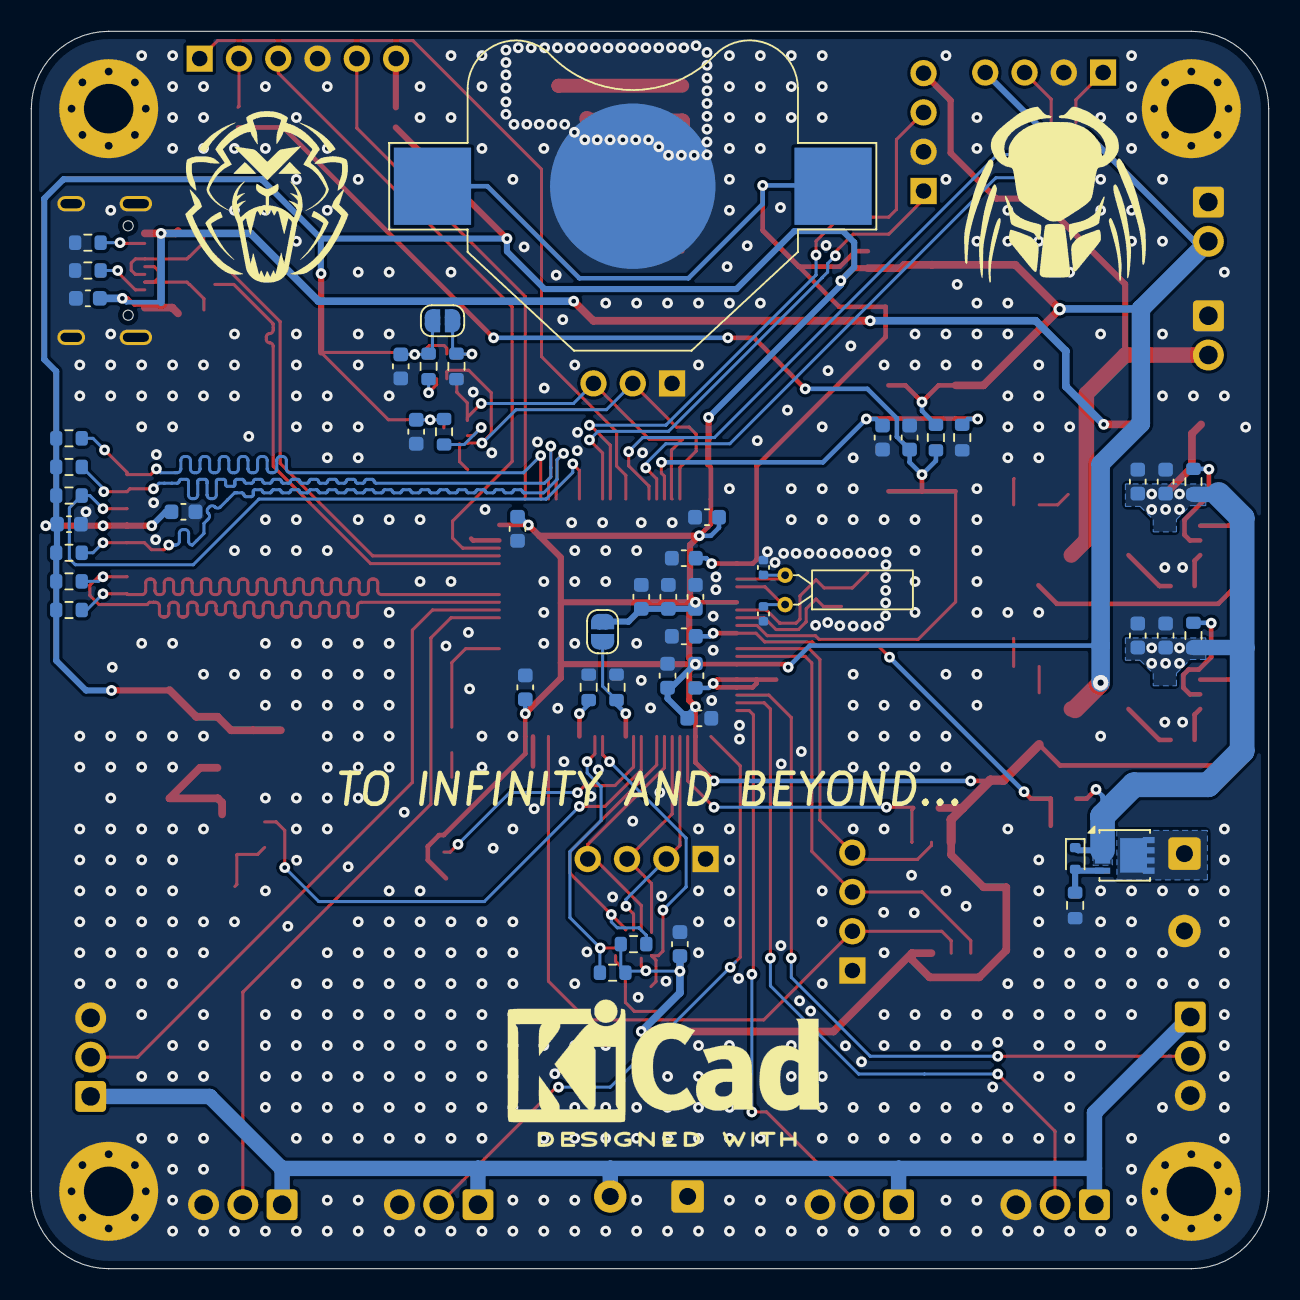
[picture p9: board VECTRON_V1.kicad_pcb from below]

Board: 2 copper layers, 80.0 x 80.0 mm, 156 parts (51 on the bottom side), 87 nets.
