ArudhranPK/VECTRON_V1/Software/Core/Src/main.c

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
/* Includes ------------------------------------------------------------------*/
#include "main.h"
#include "fatfs.h"
#include "usb_device.h"

/* USER CODE BEGIN Includes */
#include "usbd_cdc_if.h"

#include <stdio.h>
#include <stdbool.h>
#include <string.h>

#include "FLIGHT.h"

#include "drivers/ISM330DHCX/ISM330DHCX.h"
#include "drivers/BMP280/BMP280.h"
#include "drivers/LIS2MDL/LIS2MDL.h"
#include "drivers/NEO6M/NEO6M.h"
#include "drivers/ADC/ADC.h"

#include "drivers/SERVO/SERVO.h"
#include "drivers/BUZZER/BUZZER.h"
#include "drivers/WS2812/WS2812.h"

#include "drivers/W25Q128JV/W25Q128JV.h"
#include "drivers/MICROSD/MICROSD.h"

#include "drivers/DEBUGGING/DEBUGGING.h"

#include "drivers/KALMAN/KALMAN.h"

/* USER CODE END Includes */

ADC_HandleTypeDef hadc1;
DMA_HandleTypeDef hdma_adc1;

I2C_HandleTypeDef hi2c1;
DMA_HandleTypeDef hdma_i2c1_rx;
DMA_HandleTypeDef hdma_i2c1_tx;

SD_HandleTypeDef hsd;

SPI_HandleTypeDef hspi1;
SPI_HandleTypeDef hspi2;
DMA_HandleTypeDef hdma_spi1_rx;
DMA_HandleTypeDef hdma_spi1_tx;

TIM_HandleTypeDef htim1;
TIM_HandleTypeDef htim2;
TIM_HandleTypeDef htim3;
TIM_HandleTypeDef htim5;
TIM_HandleTypeDef htim8;
DMA_HandleTypeDef hdma_tim8_ch3;

UART_HandleTypeDef huart1;
UART_HandleTypeDef huart2;
DMA_HandleTypeDef hdma_usart2_rx;

/* USER CODE BEGIN PV */
uint8_t estimationTimes = 0;
uint8_t estimationFlag = 0;

FlightDataHandler_t FlightData;

typedef enum
{
    STATE_READING_BMP,
    STATE_READING_LIS
} I2CSequenceState_t;

volatile I2CSequenceState_t I2CdmaState = STATE_READING_BMP;

ISM330DHCX_Handle_t ISM330DHCX_Handler;
BMP280_Handle_t BMP280_Handler;
LIS2MDL_Handle_t LIS2MDL_Handler;
NEO6M_Handle_t NEO6M_Handler;
ADC_Handle_t ADC_Handler;

Servo_Handle_t servoX1;
Servo_Handle_t servoX2;
Servo_Handle_t servoY1;
Servo_Handle_t servoY2;

Servo_Handle_t servoRecov1;
Servo_Handle_t servoRecov2;

Buzzer_Handle_t Buzzer_Handler;
WS2812_Handle_t WS2812_Handler;

W25Q128JV_Handle_t W25Q128JV_Handler;

KalmanFilterState_t g_kalman_state = {0};

char output[1024];
/* USER CODE END PV */

void SystemClock_Config(void);
static void MX_GPIO_Init(void);
static void MX_DMA_Init(void);
static void MX_ADC1_Init(void);
static void MX_I2C1_Init(void);
static void MX_TIM1_Init(void);
static void MX_TIM2_Init(void);
static void MX_TIM3_Init(void);
static void MX_TIM5_Init(void);
static void MX_USART1_UART_Init(void);
static void MX_USART2_UART_Init(void);
static void MX_SDIO_SD_Init(void);
static void MX_SPI1_Init(void);
static void MX_SPI2_Init(void);
static void MX_TIM8_Init(void);
/* USER CODE BEGIN 0 */

HAL_StatusTypeDef flightComputerInit(FlightDataHandler_t *flight)
{
    // Initialize sensors
    ISM330DHCXInit(&ISM330DHCX_Handler);
    BMP280Init(&BMP280_Handler);
    LIS2MDLInit(&LIS2MDL_Handler);
    NEO6MInit(&NEO6M_Handler);
    ADCInit(&ADC_Handler);
    // Start timer for timestamp
    HAL_TIM_Base_Start_IT(&htim5);

    // Initialize servos
    Servo_Init_LUT();
    ServoInit(&servoX1);
    ServoInit(&servoX2);
    ServoInit(&servoY1);
    ServoInit(&servoY2);
    ServoInit(&servoRecov1);
    ServoInit(&servoRecov2);

    // Initialize other peripherals
    BuzzerInit(&Buzzer_Handler);
    WS2812_Init(&WS2812_Handler);

    //  Initialize data storage elements
    W25Q128JVInit(&W25Q128JV_Handler);
//    W25Q128JVCleanSlate(&W25Q128JV_Handler);

    // Initial sensor readings
    NEO6MReadRaw(&NEO6M_Handler);
    BMP280ReadRaw(&BMP280_Handler);
    ISM330DHCXReadRaw(&ISM330DHCX_Handler);

    // Initialize flight data structure
    flight->start_byte = 0xAA; // Example start byte
    flight->packet_count = 0;
    flight->system_state = 0;
    flight->flight_state = 0;
    flight->error_flags = 0;

    return HAL_OK;
}

HAL_StatusTypeDef flightComputerCopySensors(FlightDataHandler_t *flight)
{
    // Copy timestamp
    flight->timestamp_ms = HAL_GetTick();

    // Copy IMU data (accelerometer)
    flight->accel_x = ISM330DHCX_Handler.accel_g_x;
    flight->accel_y = ISM330DHCX_Handler.accel_g_y;
    flight->accel_z = ISM330DHCX_Handler.accel_g_z;

    // Copy IMU data (gyroscope)
    flight->gyro_x = ISM330DHCX_Handler.gyro_dps_x;
    flight->gyro_y = ISM330DHCX_Handler.gyro_dps_y;
    flight->gyro_z = ISM330DHCX_Handler.gyro_dps_z;

    // Copy IMU temperature
    flight->temp_imu = ISM330DHCX_Handler.temperature;

    // Copy barometer data
    flight->pressure = BMP280_Handler.pressure;
    flight->altitude = BMP280_Handler.altitude;
    flight->temp_baro = BMP280_Handler.temperature;

    // Copy magnetometer/attitude data
    flight->roll = LIS2MDL_Handler.mag_x;
    flight->pitch = LIS2MDL_Handler.mag_y;
    flight->yaw = LIS2MDL_Handler.mag_z;

    // Copy GPS data
    flight->gps_sats = NEO6M_Handler.SatellitesUsed;
    flight->gps_lat = NEO6M_Handler.Latitude;
    flight->gps_lon = NEO6M_Handler.Longitude;
    flight->gps_alt = NEO6M_Handler.Altitude;

    // Copy ADC voltage
    flight->battery_voltage = ADC_Handler.voltage;

    // Copy servo positions
    flight->servoAngleX1 = servoX1.angle;
    flight->servoAngleX2 = servoX2.angle;
    flight->servoAngleY1 = servoY1.angle;
    flight->servoAngleY2 = servoY2.angle;
    flight->servoRecov1 = servoRecov1.angle;
    flight->servoRecov2 = servoRecov2.angle;

    // Increment packet counter
    flight->packet_count++;

    return HAL_OK;
}

HAL_StatusTypeDef flightComputerEstimation(FlightDataHandler_t *flight)
{
    // Initialize Kalman filters on first call
    static bool first_call = true;
    if (first_call)
    {
        Kalman_Init(&g_kalman_state);
        first_call = false;
    }

    // Update altitude and velocity estimation
    Kalman_UpdateAltitude(&g_kalman_state.altitude_filter,
                          flight->altitude,
                          flight->gps_alt,
                          flight->gps_sats,
                          flight->accel_z,
                          flight->timestamp_ms);

    // Update attitude estimation
    Kalman_UpdateAttitude(&g_kalman_state.attitude_filter,
                          flight->roll,
                          flight->pitch,
                          flight->yaw,
                          flight->gyro_x,
                          flight->gyro_y,
                          flight->gyro_z,
                          flight->timestamp_ms);

    // Update temperature estimation
    flight->est_temperature = Kalman_UpdateTemperature(&g_kalman_state.temp_filter,
                                                       flight->temp_imu,
                                                       flight->temp_baro);

    // Copy estimated values to flight data structure
    flight->est_altitude = g_kalman_state.altitude_filter.state[0];
    flight->est_velocity_z = g_kalman_state.altitude_filter.state[1];
    flight->est_roll = g_kalman_state.attitude_filter.state[0];
    flight->est_pitch = g_kalman_state.attitude_filter.state[1];
    flight->est_yaw = g_kalman_state.attitude_filter.state[2];

    return HAL_OK;
}

/* USER CODE END 0 */

/**
 * @brief  The application entry point.
 * @retval int
 */
int main(void)
{

    /* USER CODE BEGIN 1 */
    ISM330DHCX_Handler.hspi = &hspi1;
    ISM330DHCX_Handler.CSPort = IMU_CS_GPIO_Port;
    ISM330DHCX_Handler.CSPin = IMU_CS_Pin;

    BMP280_Handler.hi2c = &hi2c1;
    BMP280_Handler.address = 0x76;

    LIS2MDL_Handler.hi2c = &hi2c1;

    NEO6M_Handler.huart = &huart2;

    ADC_Handler.hadc = &hadc1;

    servoX1.htim = &htim2;
    servoX1.TIM_CHANNEL = TIM_CHANNEL_1;
    servoX2.htim = &htim2;
    servoX2.TIM_CHANNEL = TIM_CHANNEL_2;
    servoY1.htim = &htim2;
    servoY1.TIM_CHANNEL = TIM_CHANNEL_3;
    servoY2.htim = &htim2;
    servoY2.TIM_CHANNEL = TIM_CHANNEL_4;

    servoRecov1.htim = &htim3;
    servoRecov1.TIM_CHANNEL = TIM_CHANNEL_1;
    servoRecov2.htim = &htim3;
    servoRecov2.TIM_CHANNEL = TIM_CHANNEL_2;

    Buzzer_Handler.htim = &htim1;
    Buzzer_Handler.TIM_CHANNEL = TIM_CHANNEL_2;

    WS2812_Handler.htim = &htim8;
    WS2812_Handler.TIM_CHANNEL = TIM_CHANNEL_3;
    WS2812_Handler.brightness = 255;

    W25Q128JV_Handler.hspi = &hspi2;
    W25Q128JV_Handler.CsPort = FLASH_CS_GPIO_Port;
    W25Q128JV_Handler.CsPin = FLASH_CS_Pin;
    W25Q128JV_Handler.currentOffset = 0;

    /* USER CODE END 1 */

    /* MCU Configuration--------------------------------------------------------*/

    /* Reset of all peripherals, Initializes the Flash interface and the Systick. */
    HAL_Init();

    /* Configure the system clock */
    SystemClock_Config();

    /* Initialize all configured peripherals */
    MX_GPIO_Init();
    MX_DMA_Init();
    MX_ADC1_Init();
    MX_I2C1_Init();
    MX_TIM1_Init();
    MX_TIM2_Init();
    MX_TIM3_Init();
    MX_TIM5_Init();
    MX_USART1_UART_Init();
    MX_USART2_UART_Init();
    MX_SDIO_SD_Init();
    MX_SPI1_Init();
    MX_SPI2_Init();
    MX_FATFS_Init();
    MX_USB_DEVICE_Init();
    MX_TIM8_Init();
    /* USER CODE BEGIN 2 */

    ///////////////////////////////////////////////////////////////////
    // Init function
    flightComputerInit(&FlightData);

    BuzzerPlayNote(&Buzzer_Handler, NOTE_G5);
    HAL_Delay(100);
    BuzzerPlayNote(&Buzzer_Handler, NOTE_B5);
    HAL_Delay(100);
    BuzzerPlayNote(&Buzzer_Handler, NOTE_D6);
    HAL_Delay(100);
    BuzzerPlayNote(&Buzzer_Handler, NOTE_G6);
    HAL_Delay(100);
    BuzzerPlayNote(&Buzzer_Handler, NOTE_B6);
    HAL_Delay(100);
    BuzzerPlayNote(&Buzzer_Handler, NOTE_DS7);
    HAL_Delay(80);
    BuzzerPlayNote(&Buzzer_Handler, NOTE_E7);
    HAL_Delay(400);
    BuzzerPlayNote(&Buzzer_Handler, NOTE_REST);

    /* USER CODE END 2 */

    /* Infinite loop */
    /* USER CODE BEGIN WHILE */
    while (1)
    {
        if (estimationFlag)
        {

            snprintf(output, sizeof(output),
                     "--- Packet: %lu ---\n"
                     "Time: %lu ms | Sys: %u | Flight: %u | Err: 0x%02X\n"
                     "IMU Acc: [%.2f, %.2f, %.2f]\n"
                     "IMU Gyr: [%.2f, %.2f, %.2f]\n"
                     "IMU Temp: %.2f\n"
                     "Baro: P:%.2f Alt:%.2f T:%.2f\n"
                     "Mag (RPY): %.2f, %.2f, %.2f\n"
                     "GPS: Sats:%u Lat:%.7f Lon:%.7f Alt:%.2f\n"
                     "KF Est: Alt:%.2f Vel:%.2f RPY:[%.2f, %.2f, %.2f] T:%.2f\n"
                     "Batt: %.2f V\n"
                     "Servos: X[%u, %u] Y[%u, %u] Rec[%u, %u]\n\n",

                     // Header
                     FlightData.packet_count,
                     FlightData.timestamp_ms,
                     FlightData.system_state,
                     FlightData.flight_state,
                     FlightData.error_flags,

                     // IMU
                     FlightData.accel_x, FlightData.accel_y, FlightData.accel_z,
                     FlightData.gyro_x, FlightData.gyro_y, FlightData.gyro_z,
                     FlightData.temp_imu,

                     // Barometer
                     FlightData.pressure,
                     FlightData.altitude,
                     FlightData.temp_baro,

                     // Magnetometer / Orientation
                     FlightData.roll, FlightData.pitch, FlightData.yaw,

                     // GPS (Notice %.7f for Lat/Lon)
                     FlightData.gps_sats,
                     FlightData.gps_lat,
                     FlightData.gps_lon,
                     FlightData.gps_alt,

                     // Kalman Filter Estimates
                     FlightData.est_altitude,
                     FlightData.est_velocity_z,
                     FlightData.est_roll, FlightData.est_pitch, FlightData.est_yaw,
                     FlightData.est_temperature,

                     // Battery
                     FlightData.battery_voltage,

                     // Servos
                     FlightData.servoAngleX1, FlightData.servoAngleX2,
                     FlightData.servoAngleY1, FlightData.servoAngleY2,
                     FlightData.servoRecov1, FlightData.servoRecov2);

            debugging(output);
            ///////////////////////////////////////////////////////////////////
            //    copying function of flight data form various sensors
            flightComputerCopySensors(&FlightData);

            ///////////////////////////////////////////////////////////////////
            //    estimation function
            flightComputerEstimation(&FlightData);

            switch (FlightData.flight_state)
            {
            case STATE_GROUND_IDLE:
                if (1) //////////////////////////////////////  LOGIC
                {
                    FlightData.flight_state = STATE_POWERED_FLIGHT;
                    break;
                }

                break;
            ///////////////////////////////////////////////////////////////////////////////////////////////
            case STATE_POWERED_FLIGHT:
                if (1) //////////////////////////////////////  LOGIC
                {
                    FlightData.flight_state = STATE_UNPOWERED_FLIGHT;
                    break;
                }

                break;

            ///////////////////////////////////////////////////////////////////////////////////////////////
            case STATE_UNPOWERED_FLIGHT:
                if (1) //////////////////////////////////////  LOGIC
                {
                    FlightData.flight_state = STATE_BALLISTIC_DESCENT;
                    break;
                }
                break;

            ///////////////////////////////////////////////////////////////////////////////////////////////
            case STATE_BALLISTIC_DESCENT:
                if (1) //////////////////////////////////////  LOGIC
                {
                    FlightData.flight_state = STATE_CHUTE_DESCENT;
                    break;
                }
                break;
            ///////////////////////////////////////////////////////////////////////////////////////////////
            case STATE_CHUTE_DESCENT:
                if (1) //////////////////////////////////////  LOGIC
                {
                    FlightData.flight_state = STATE_LANDING_SAFE;
                    break;
                }

                break;
            ///////////////////////////////////////////////////////////////////////////////////////////////
            case STATE_LANDING_SAFE:

                break;
            }

            estimationTimes++;
            W25Q128JVWritePage(&W25Q128JV_Handler, &FlightData);
            if (estimationTimes == 2)
            {
                estimationTimes = 0;
            }

            estimationFlag = 0;
        }
        /* USER CODE END WHILE */

        /* USER CODE BEGIN 3 */
    }
    /* USER CODE END 3 */
}

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
/* USER CODE BEGIN 4 */
void HAL_GPIO_EXTI_Callback(uint16_t GPIO_Pin)
{
    if (GPIO_Pin == IMU_INT_1_Pin)
    {
        ISM330DHCXReadRaw(&ISM330DHCX_Handler);
    }
}

void HAL_SPI_TxRxCpltCallback(SPI_HandleTypeDef *hspi)
{
    if (hspi->Instance == SPI1)
    {

        HAL_GPIO_WritePin(ISM330DHCX_Handler.CSPort, ISM330DHCX_Handler.CSPin, GPIO_PIN_SET);
        ISM330DHCXRawToData(&ISM330DHCX_Handler);
    }
}

void HAL_TIM_PeriodElapsedCallback(TIM_HandleTypeDef *htim)
{
    if (htim->Instance == TIM5)
    {
        BMP280ReadRaw(&BMP280_Handler);
    }
}

void HAL_I2C_MemRxCpltCallback(I2C_HandleTypeDef *hi2c)
{
    if (hi2c->Instance == I2C1)
    {
        if (I2CdmaState == STATE_READING_BMP)
        {
            // BMP finished! Now start LIS2MDL immediately
            ADCReadRaw(&ADC_Handler);
            LIS2MDLReadRaw(&LIS2MDL_Handler);
            I2CdmaState = STATE_READING_LIS;

            BMP280RawToData(&BMP280_Handler);
        }
        else if (I2CdmaState == STATE_READING_LIS)
        {
            // LIS finished! The sequencing chain is done.
            I2CdmaState = STATE_READING_BMP;

            LIS2MDLRawToData(&LIS2MDL_Handler);

            estimationFlag = 1;
        }
    }
}

void HAL_UART_RxCpltCallback(UART_HandleTypeDef *huart)
{
    if (huart->Instance == USART2)
    {
        if (NEO6M_Handler.tempByte == '$')
        {
            /* FOUND IT! Sync detected. */

            // 1. Manually place '$' at the start of the buffer
            NEO6M_Handler.rawBuffer[0] = '$';

            // 2. Switch to DMA immediately to catch the rest of the sentence.
            // Notice: We point to &rawbuffer[1] because index 0 is already filled.
            // We reduce size by 1.
            HAL_UARTEx_ReceiveToIdle_DMA(NEO6M_Handler.huart, &NEO6M_Handler.rawBuffer[1], 511);
        }
        else
        {
            /* Garbage data (noise or middle of sentence). Keep Hunting. */
            HAL_UART_Receive_IT(NEO6M_Handler.huart, &NEO6M_Handler.tempByte, 1);
        }
    }
}

void HAL_UARTEx_RxEventCallback(UART_HandleTypeDef *huart, uint16_t Size)
{
    if (huart->Instance == USART2)
    {
        /* DMA has stopped receiving. We now have a full batch. */

        // The 'Size' argument is how many bytes DMA transferred.
        // Since we manually added '$' at index 0, total length is Size + 1.
        uint16_t TotalLen = Size + 1;

        // 1. Null terminate for safety
        NEO6M_Handler.rawBuffer[TotalLen] = '\0';

        // 2. Process the Clean Data

        NEO6MRawToData(&NEO6M_Handler);

        //        sprintf(output, "%s", NEO6M_Handler.rawBuffer);
        //        debugging(output);
        //
        //        sprintf(output, "Time: %d:%d:%d | Lat: %.6f | Lon: %.6f | altitude: %.2f | Sats: %d\r\n",
        //                NEO6M_Handler.Hour, // String (%s)
        //                NEO6M_Handler.Min,
        //                NEO6M_Handler.Sec,
        //                NEO6M_Handler.Latitude,      // Float with 6 decimals (%.6f)
        //                NEO6M_Handler.Longitude,     // Float with 6 decimals (%.6f)
        //                NEO6M_Handler.Altitude,      // Float with 2 decimals (%.2f)
        //                NEO6M_Handler.SatellitesUsed // Integer (%d)
        //        );
        //
        //        debugging(output);

        // 3. Reset logic: Go back to "Hunting" for the next '$'
        // We do NOT restart DMA here. We restart the single-byte Interrupt.
        HAL_UART_Receive_IT(NEO6M_Handler.huart, &NEO6M_Handler.tempByte, 1);
    }
}

void HAL_ADC_ConvCpltCallback(ADC_HandleTypeDef *hadc)
{
    if (hadc->Instance == ADC1) 
    {
        ADCRawToData(&ADC_Handler);
    }
}
/* USER CODE END 4 */
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
