ArudhranPK/VECTRON_V1/Software/VECTRON_V1.ioc

Mcu.UserName=STM32F407VGTx
PA0-WKUP.Signal=S_TIM2_CH1_ETR
PA1.Signal=S_TIM2_CH2
PA11.Signal=USB_OTG_FS_DM
PA12.Signal=USB_OTG_FS_DP
PA13.Signal=SYS_JTMS-SWDIO
PA14.Signal=SYS_JTCK-SWCLK
PA2.Signal=S_TIM2_CH3
PA3.Signal=S_TIM2_CH4
PA4.GPIO_Label=FLASH_CS
PA4.Signal=GPIO_Output
PA5.Signal=SPI1_SCK
PA6.Signal=SPI1_MISO
PA7.Signal=SPI1_MOSI
PB0.Signal=TIM1_CH2N
PB1.Signal=TIM8_CH3N
PB10.Signal=SPI2_SCK
PB3.Signal=SYS_JTDO-SWO
PB6.Signal=USART1_TX
PB7.Signal=USART1_RX
PB8.Signal=I2C1_SCL
PB9.Signal=I2C1_SDA
PC0.Signal=ADCx_IN10
PC10.Signal=SDIO_D2
PC11.Signal=SDIO_D3
PC12.Signal=SDIO_CK
PC14-OSC32_IN.Signal=RCC_OSC32_IN
PC15-OSC32_OUT.Signal=RCC_OSC32_OUT
PC2.Signal=SPI2_MISO
PC3.Signal=SPI2_MOSI
PC4.GPIO_Label=IMU_CS
PC4.Signal=GPIO_Output
PC6.Signal=S_TIM3_CH1
PC7.Signal=S_TIM3_CH2
PC8.Signal=SDIO_D0
PC9.Signal=SDIO_D1
PD12.GPIO_Label=STATUS_LED
PD12.Signal=GPIO_Output
PD2.Signal=SDIO_CMD
PD5.Signal=USART2_TX
PD6.Signal=USART2_RX
PE10.GPIO_Label=IMU_INT_2
PE10.Signal=GPXTI10
PE12.GPIO_Label=SDIO_DET
PE12.Signal=GPIO_Input
PE9.GPIO_Label=IMU_INT_1
PE9.Signal=GPXTI9
PH0-OSC_IN.Signal=RCC_OSC_IN
PH1-OSC_OUT.Signal=RCC_OSC_OUT
