ArudhranPK/VECTRON_V1/temp/temp/FLIGHT.c

#include "FLIGHT.h"

HAL_StatusTypeDef flightComputerInit(FlightDataHandler_t *flight)
{

    return HAL_OK;
}
HAL_StatusTypeDef flightComputerCopySensors(FlightDataHandler_t *flight)
{

    return HAL_OK;
}
HAL_StatusTypeDef flightComputerEstimation(FlightDataHandler_t *flight)
{

    return HAL_OK;
}
