ArudhranPK/VECTRON_V1/(commit log)

2025-08-31 Software framework
    [Vectron.kicad_pcb, Vectron.kicad_sch]
2025-09-01 changed MCU
    [VECTRON_V1.kicad_pcb, VECTRON_V1.kicad_sch, Vectron.kicad_sch]
2025-09-04 added bmp and magnetometer
    [VECTRON_V1.kicad_sch]
2025-09-07 all connections made rechecking needed
    [VECTRON_V1.kicad_sch]
2025-09-12 finished according to me :)
    [VECTRON_V1.kicad_sch]
2025-09-12 tiny changes
    [VECTRON_V1.kicad_sch]
2025-11-18 final changes
    [BOM.xlsx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]
