ArudhranPK/VECTRON_V1/(notices)

Notices in the files:
Software/Core/Src/main.c:
Copyright (c) 2025 STMicroelectronics.
All rights reserved.
This software is licensed under terms that can be found in the LICENSE file
Software/Core/Inc/main.h:
Copyright (c) 2026 STMicroelectronics.
